UWARG/ZP-breakout/README.md

# ZP-breakout
Breakout Board for Zeropilot rev 1.0.
