UWARG/ZP-breakout/sch.pdf

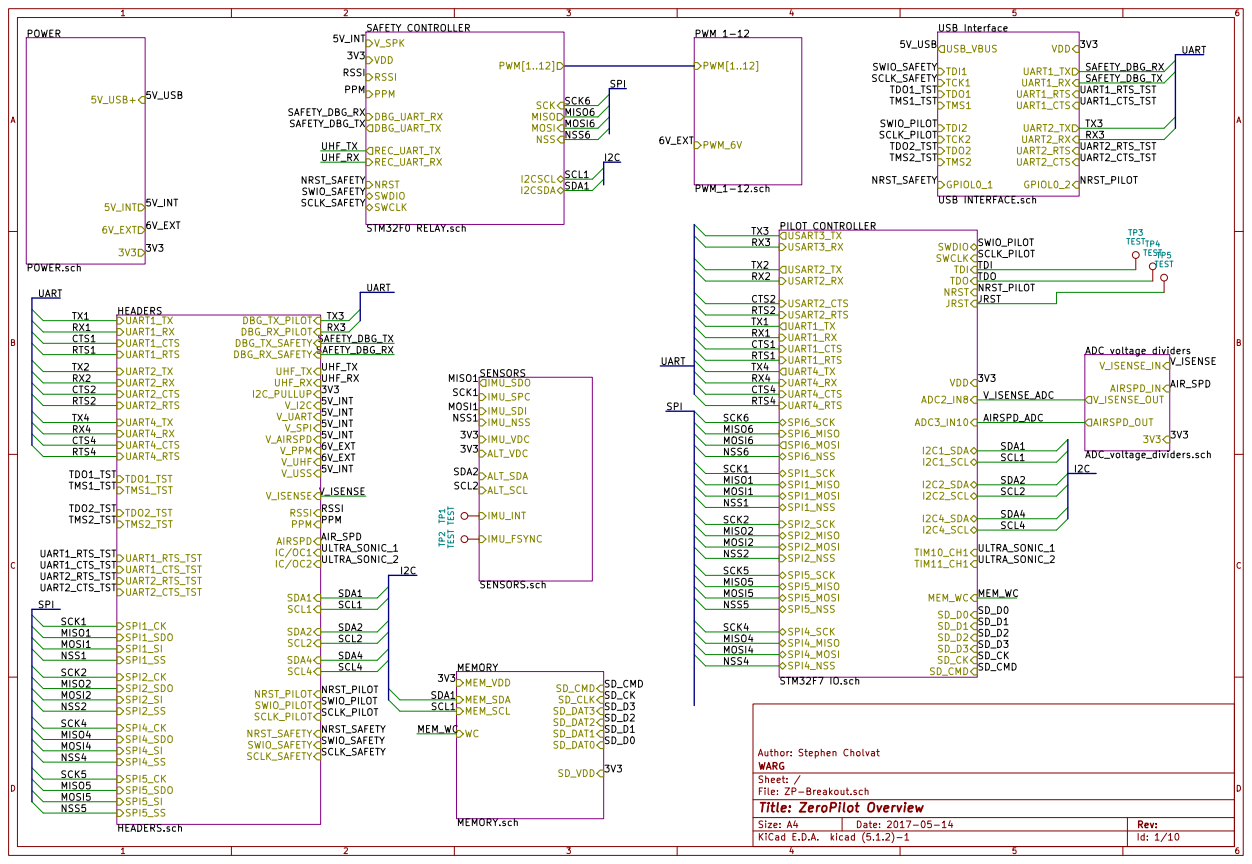
[picture p1: page 1]

Author: Stephen Cholvat
File: ZP-Breakout.sch Sheet: / WARG

Id: 1/10 Title: ZeroPilot Overview

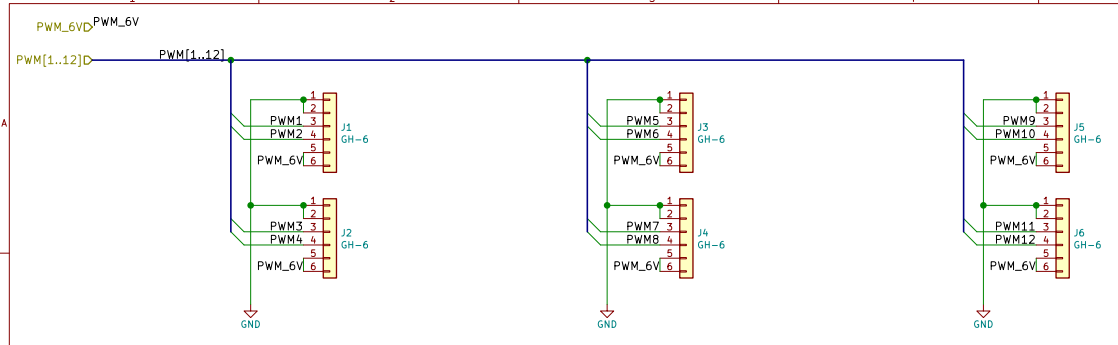
[picture p2: page 2]

Author: Stephen Cholvat
File: PWM_1-12.sch Sheet: /PWM 1-12/ WARG

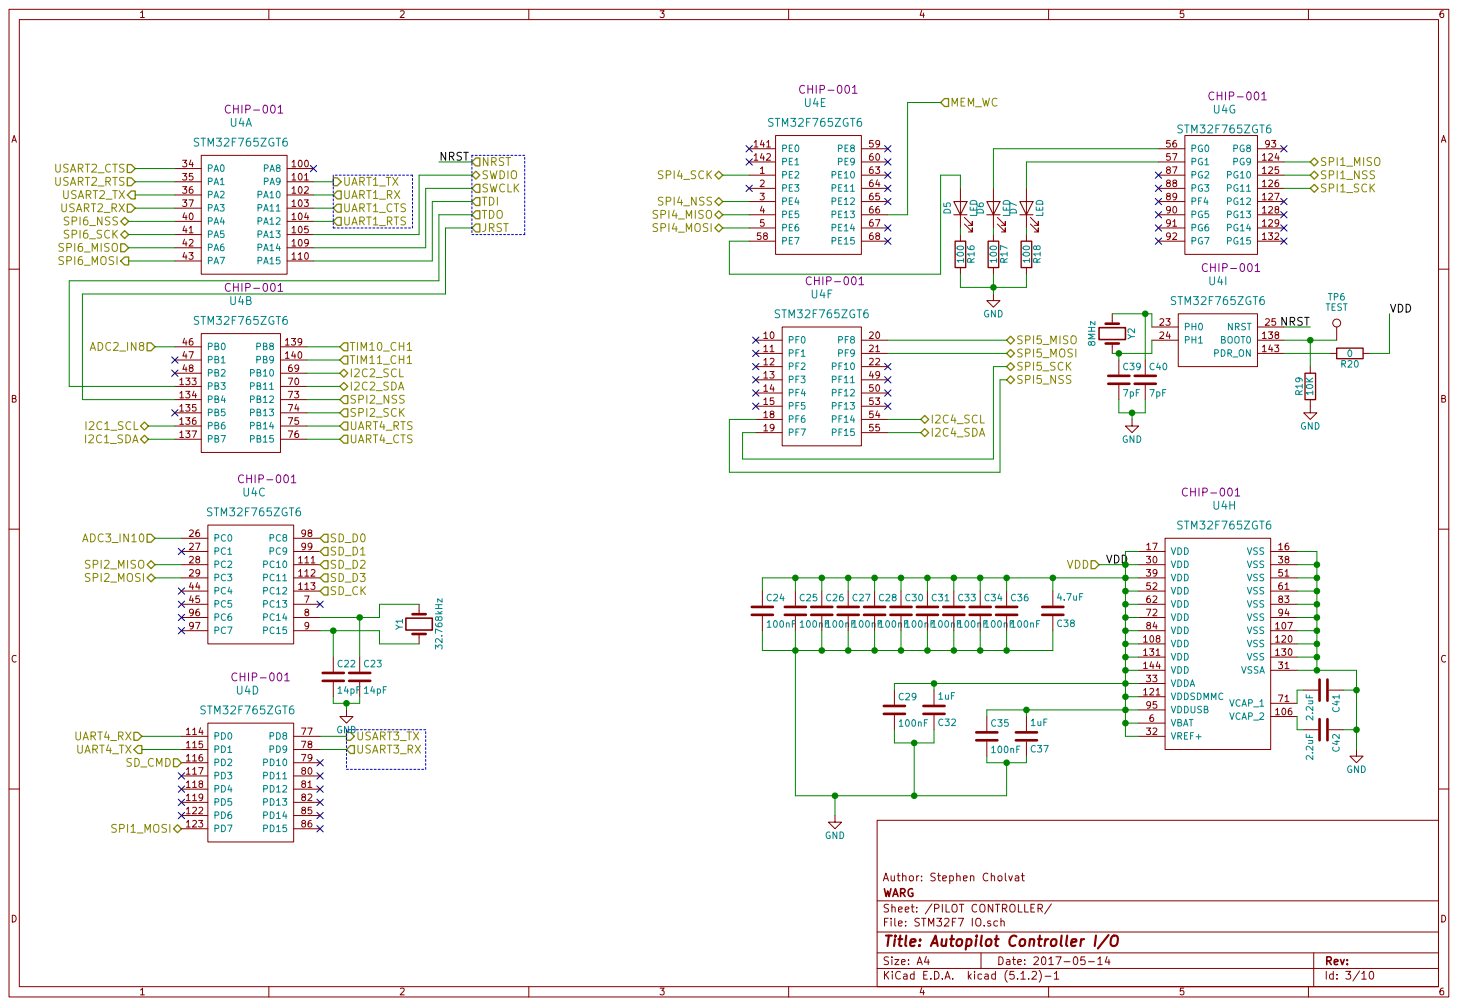
[picture p3: page 3]

Author: Stephen Cholvat
File: STM32F7 IO.sch Sheet: /PILOT CONTROLLER/ WARG

Id: 3/10 Title: Autopilot Controller I/O

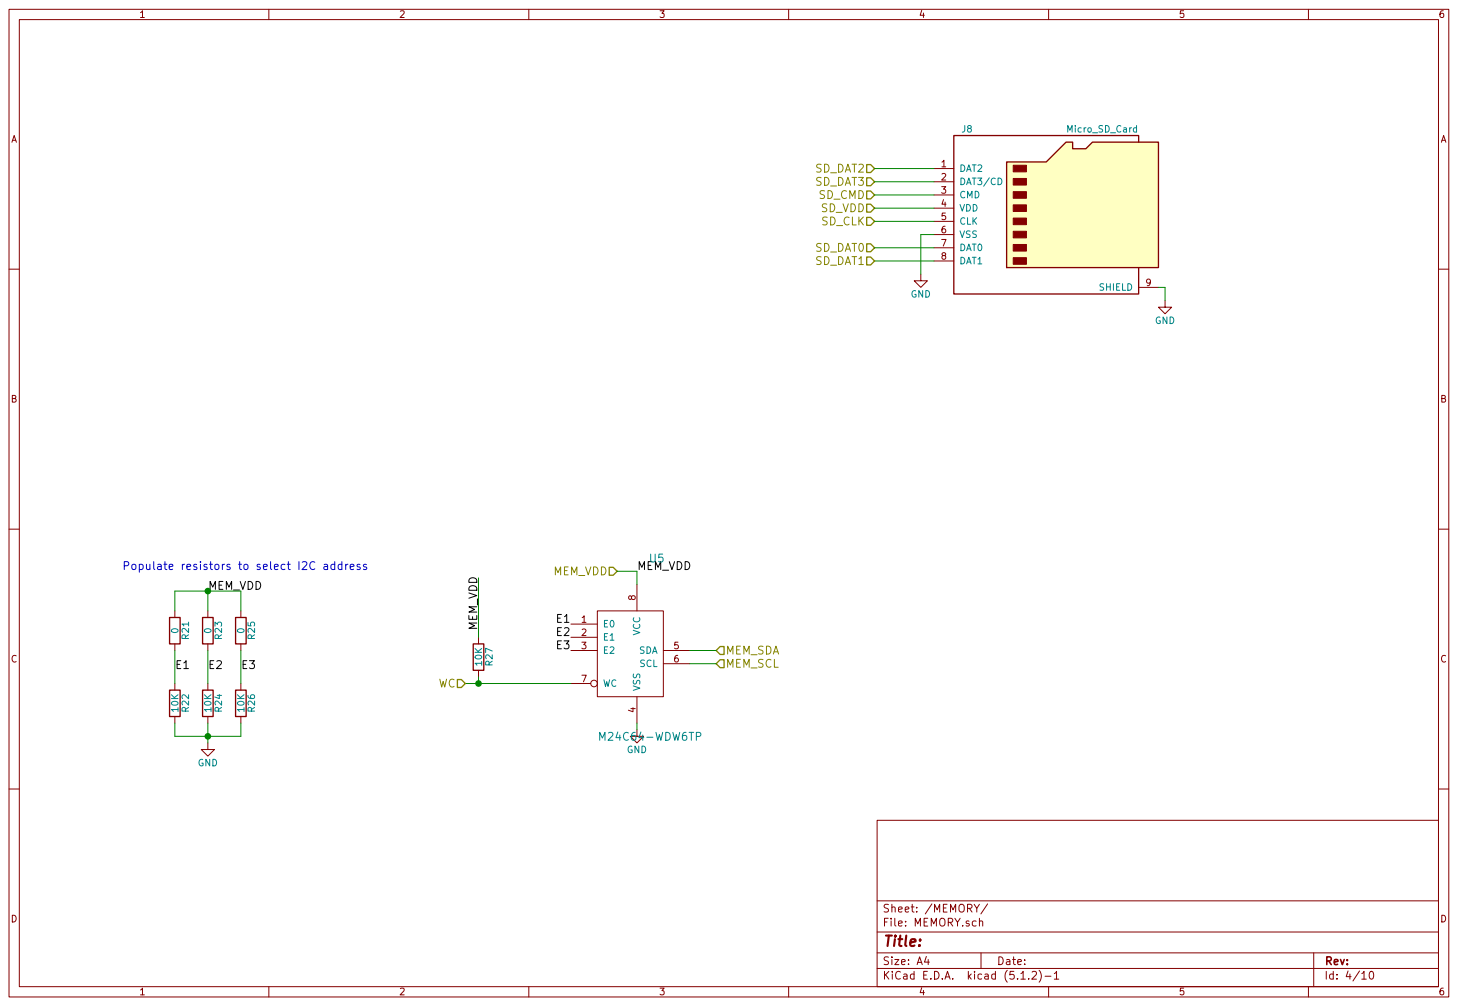
[picture p4: page 4]

4 SDA 5 SCL 6 WC 7 VCC

Id: 4/10 Title: File: MEMORY.sch Sheet: /MEMORY/

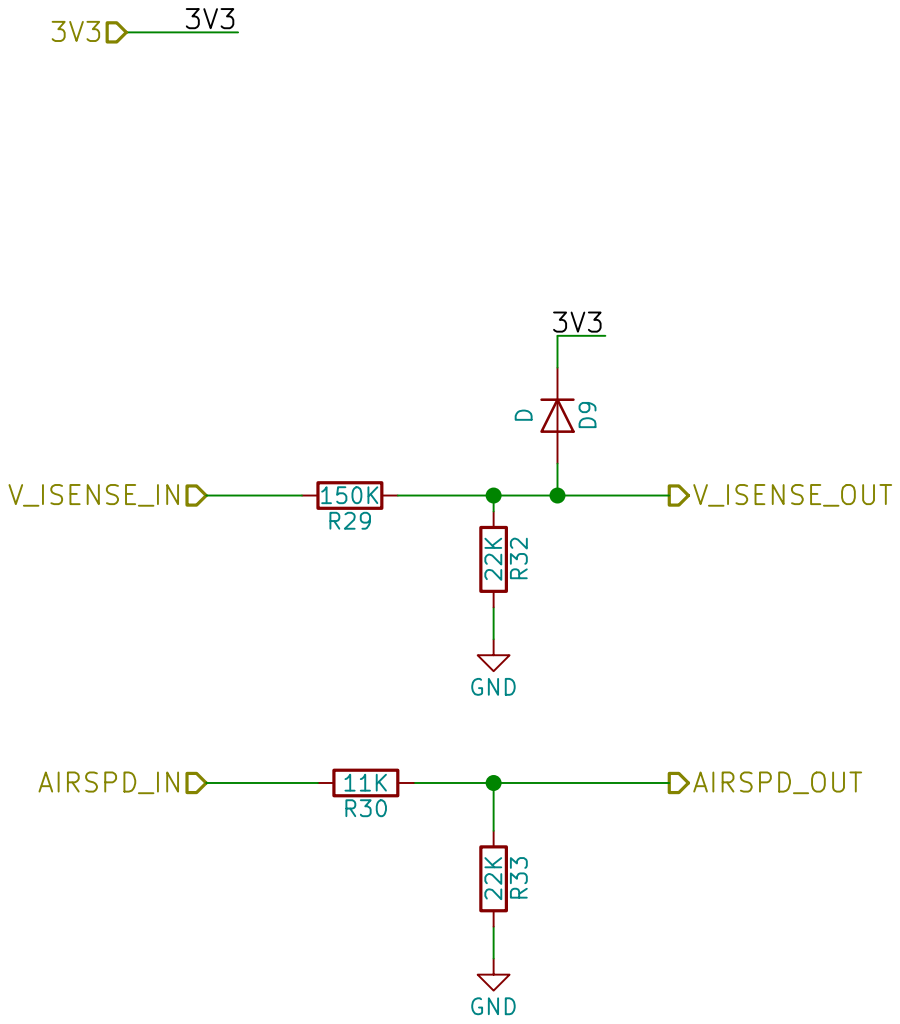
[picture p5: page 5]

Sheet: /ADC voltage dividers/
File: ADC_voltage_dividers.sch
Id: 5/10 Title:

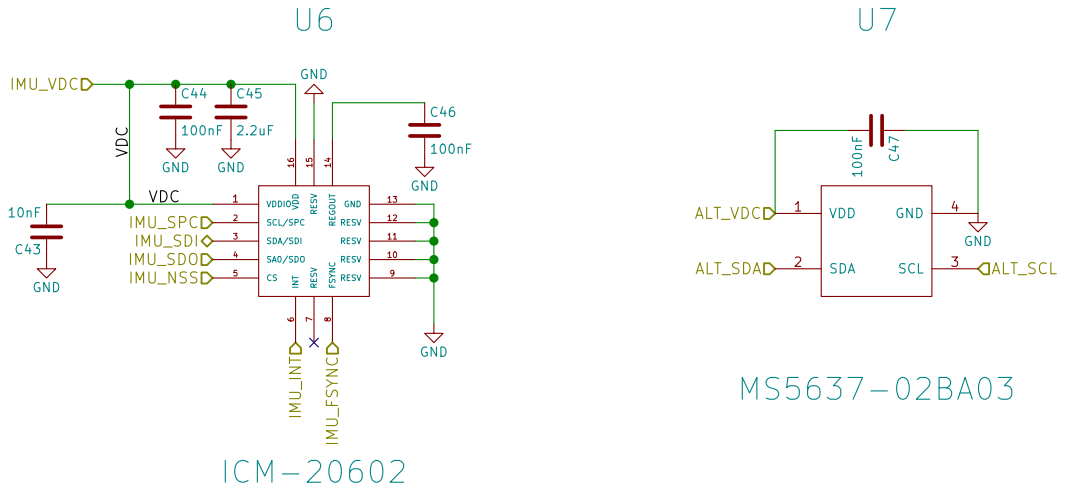
[picture p6: page 6]

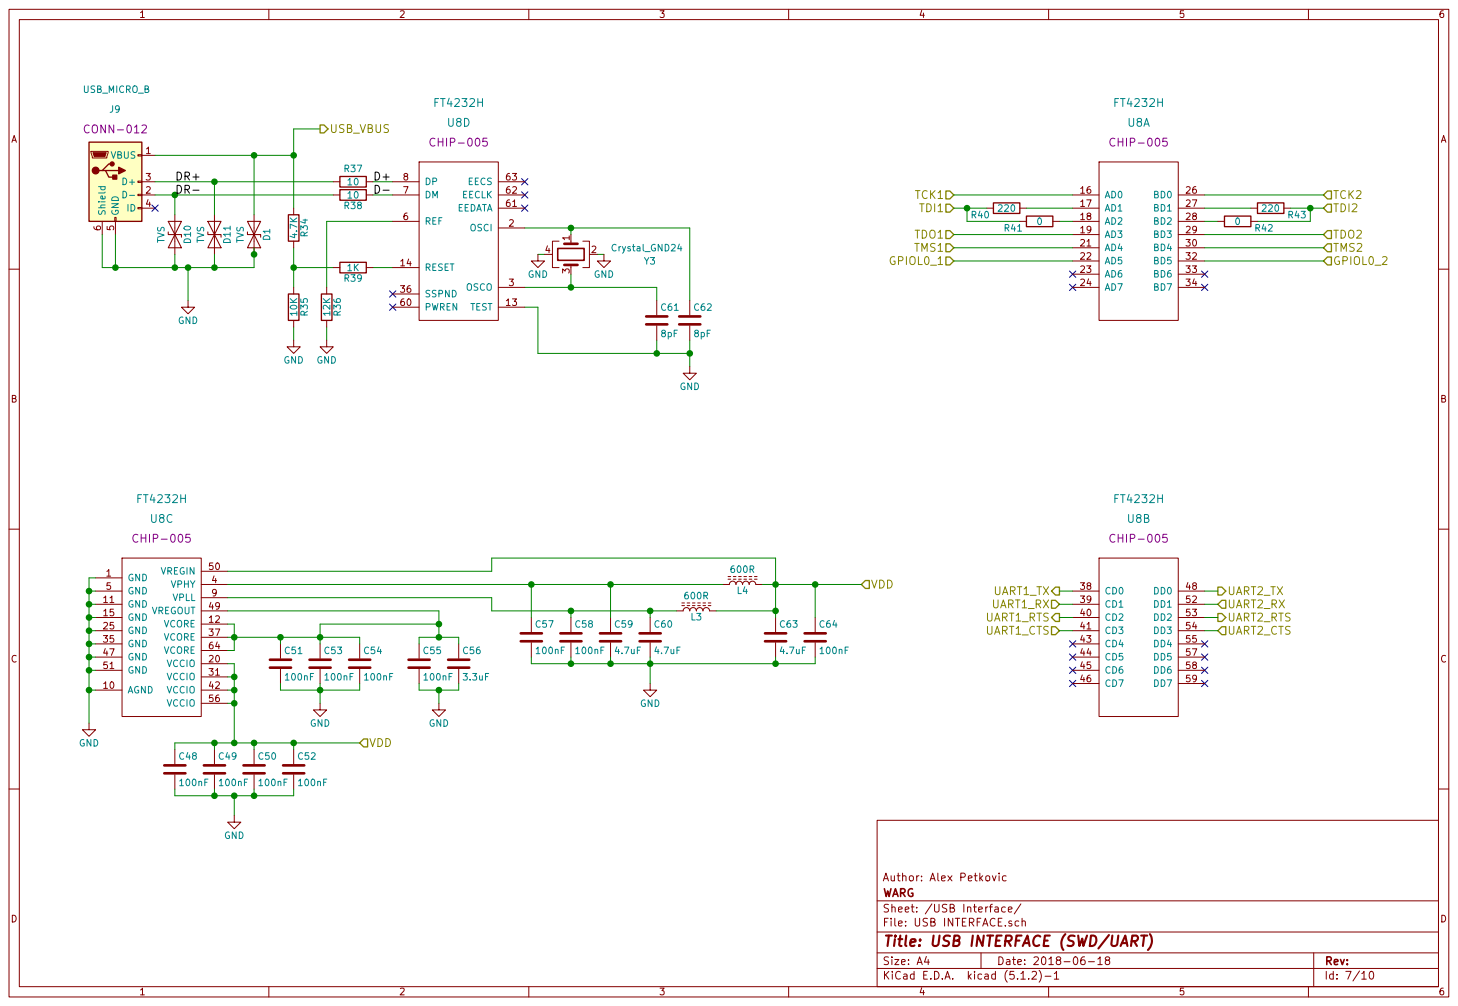
[picture p7: page 7]

Id: 7/10 Title: USB INTERFACE (SWD/UART) File: USB INTERFACE.sch Sheet: /USB Interface/ WARG

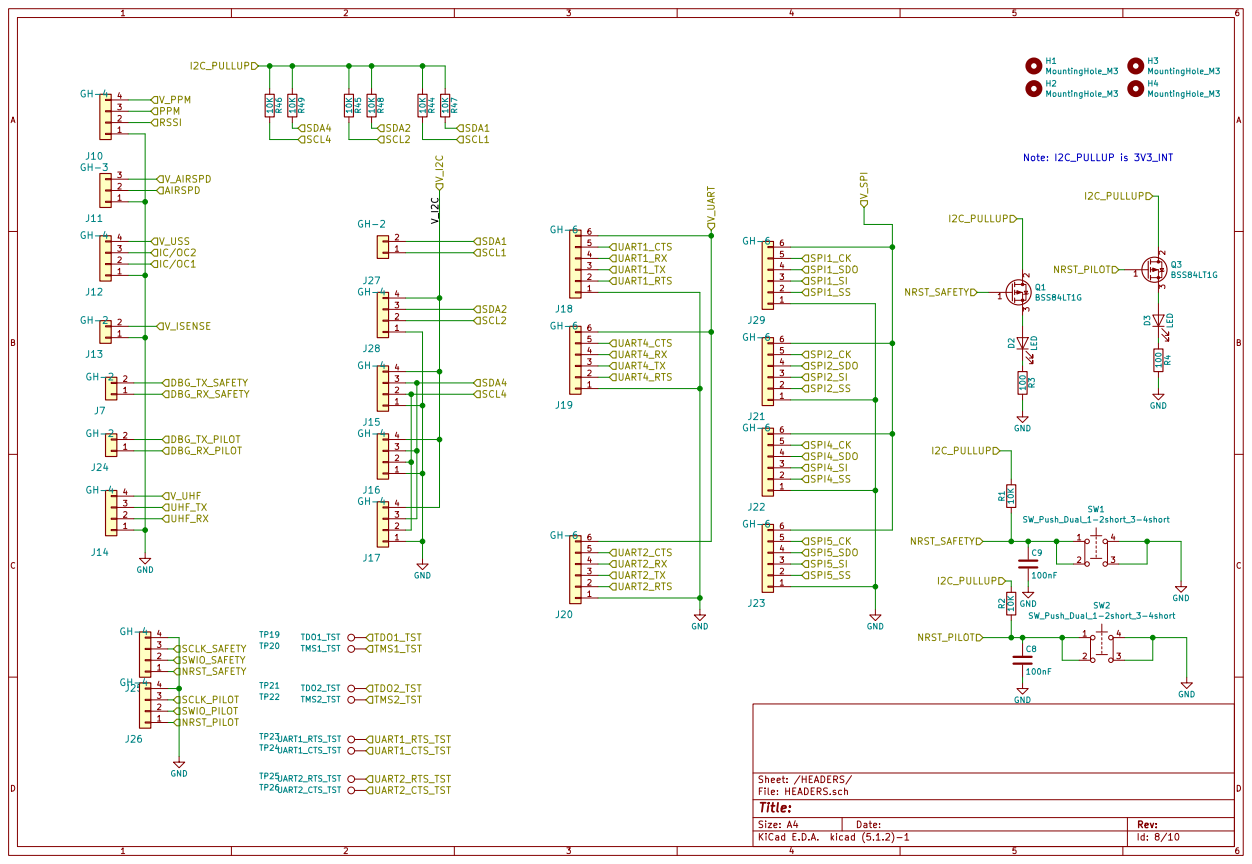
[picture p8: page 8]

Id: 8/10 Title: File: HEADERS.sch Sheet: /HEADERS/

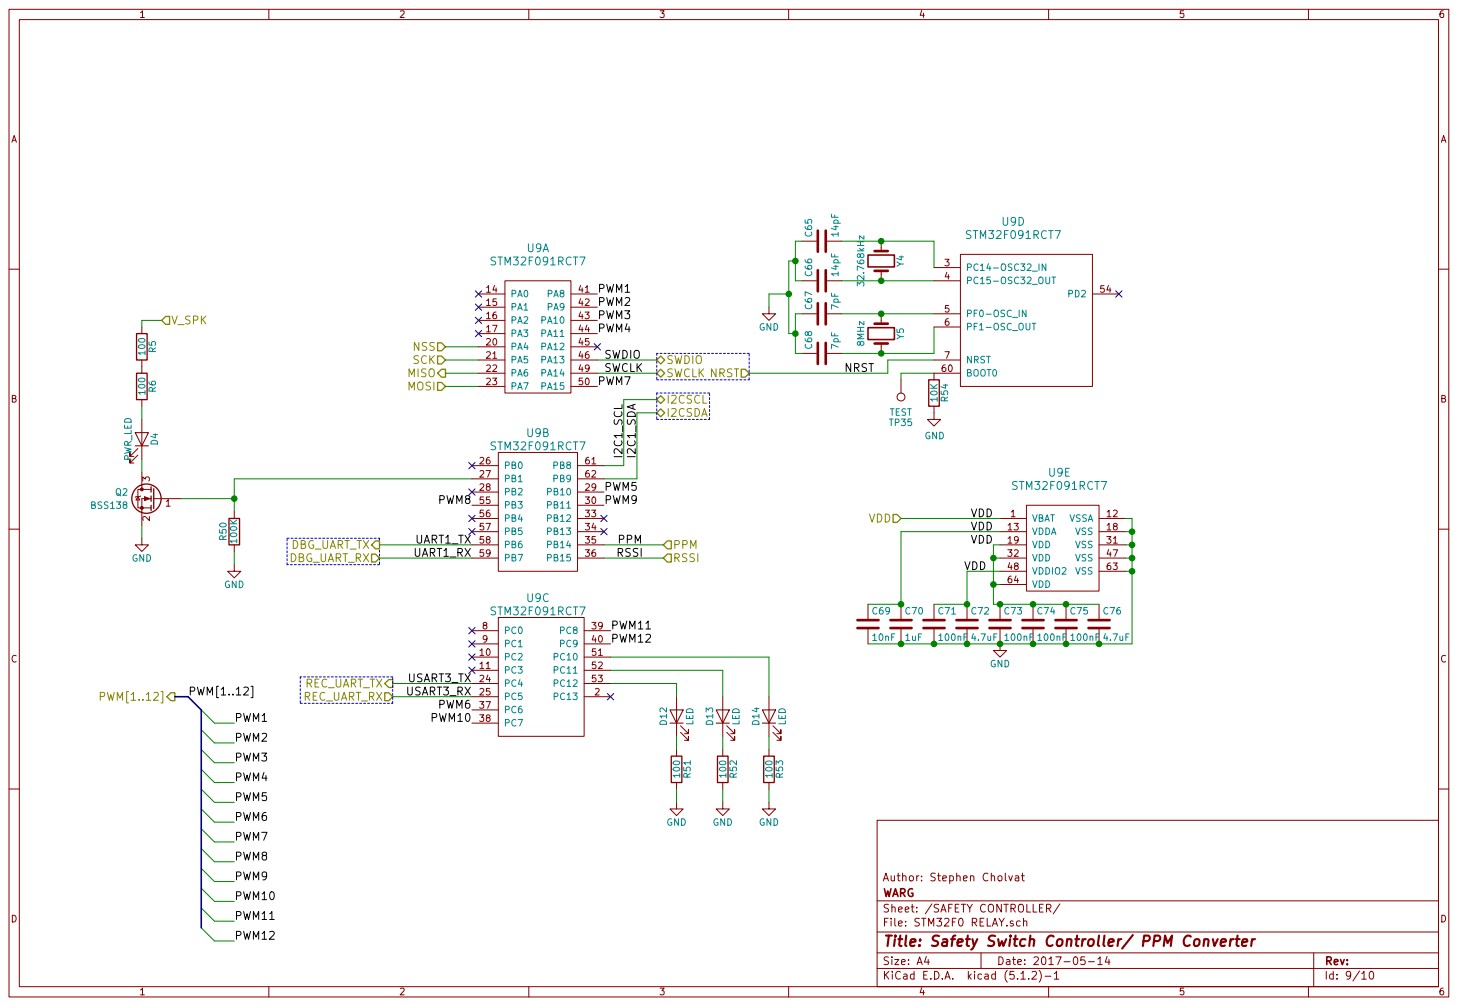
[picture p9: page 9]

Id: 9/10 Title: Safety Switch Controller/ PPM Converter File: STM32F0 RELAY.sch Sheet: /SAFETY CONTROLLER/ WARG

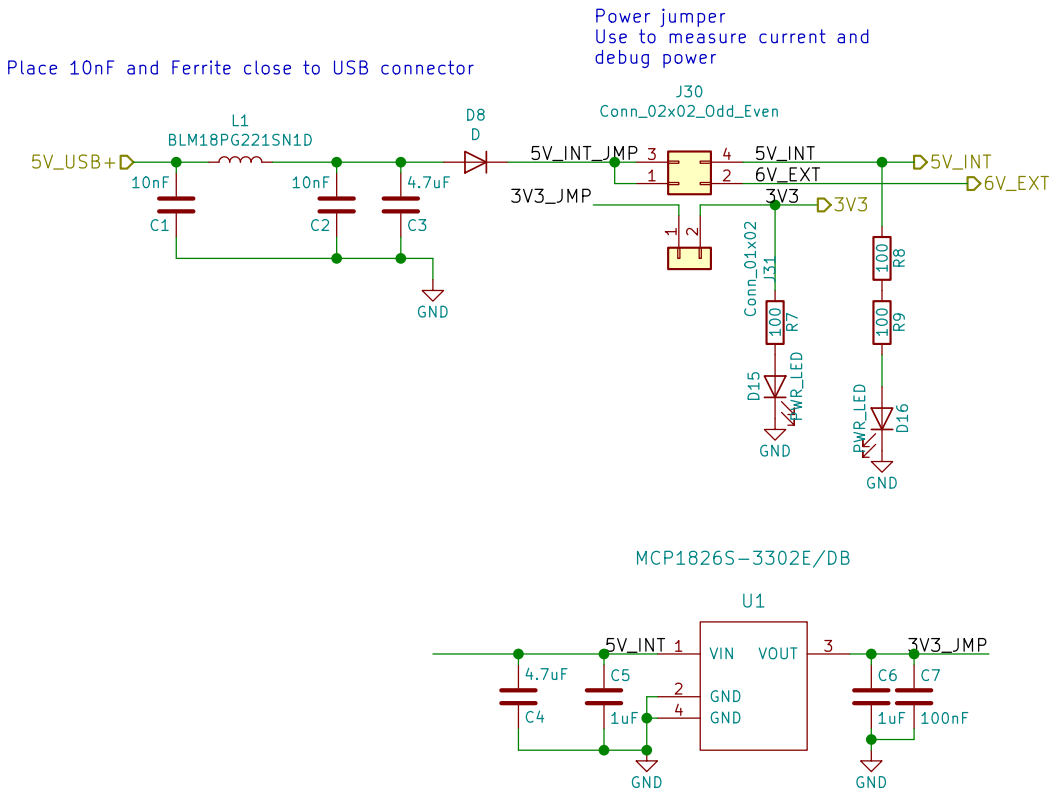
[picture p10: page 10]

Power jumper Use to measure current and
debug power C5
6V_EXT

Id: 10/10 Title: File: POWER.sch Sheet: /POWER/ WARG
