UWARG/ZP-breakout/pcb.pdf

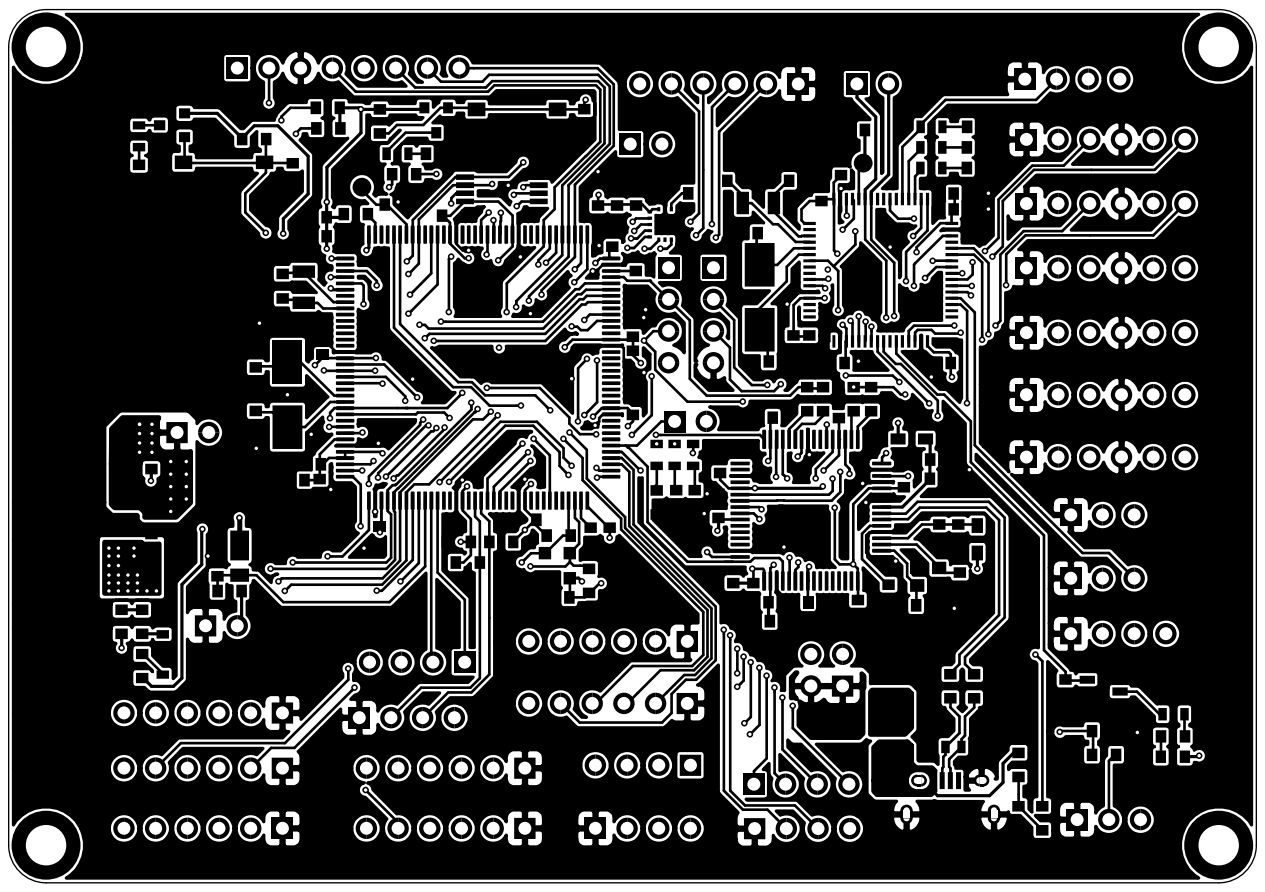
[picture p11: page 1]

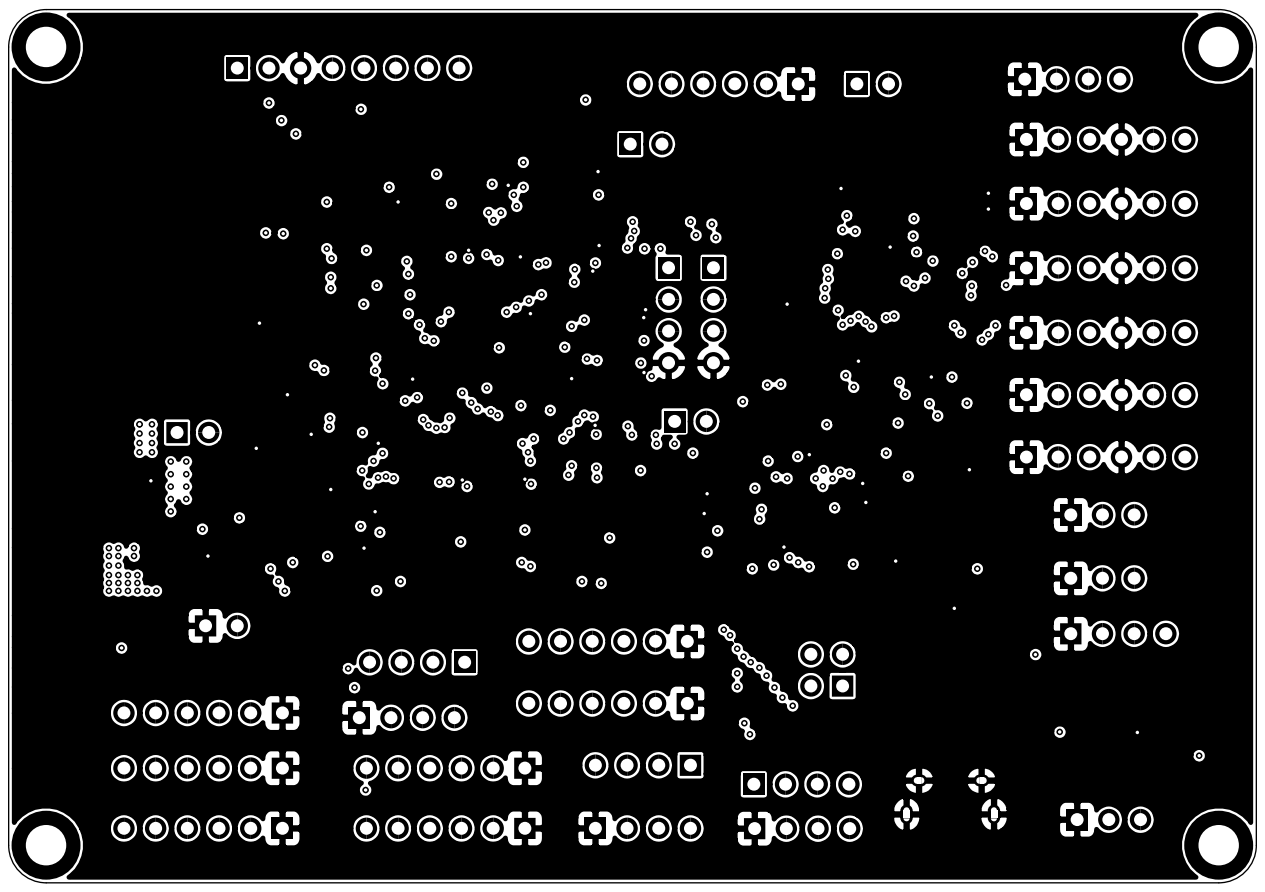
[picture p12: page 2]

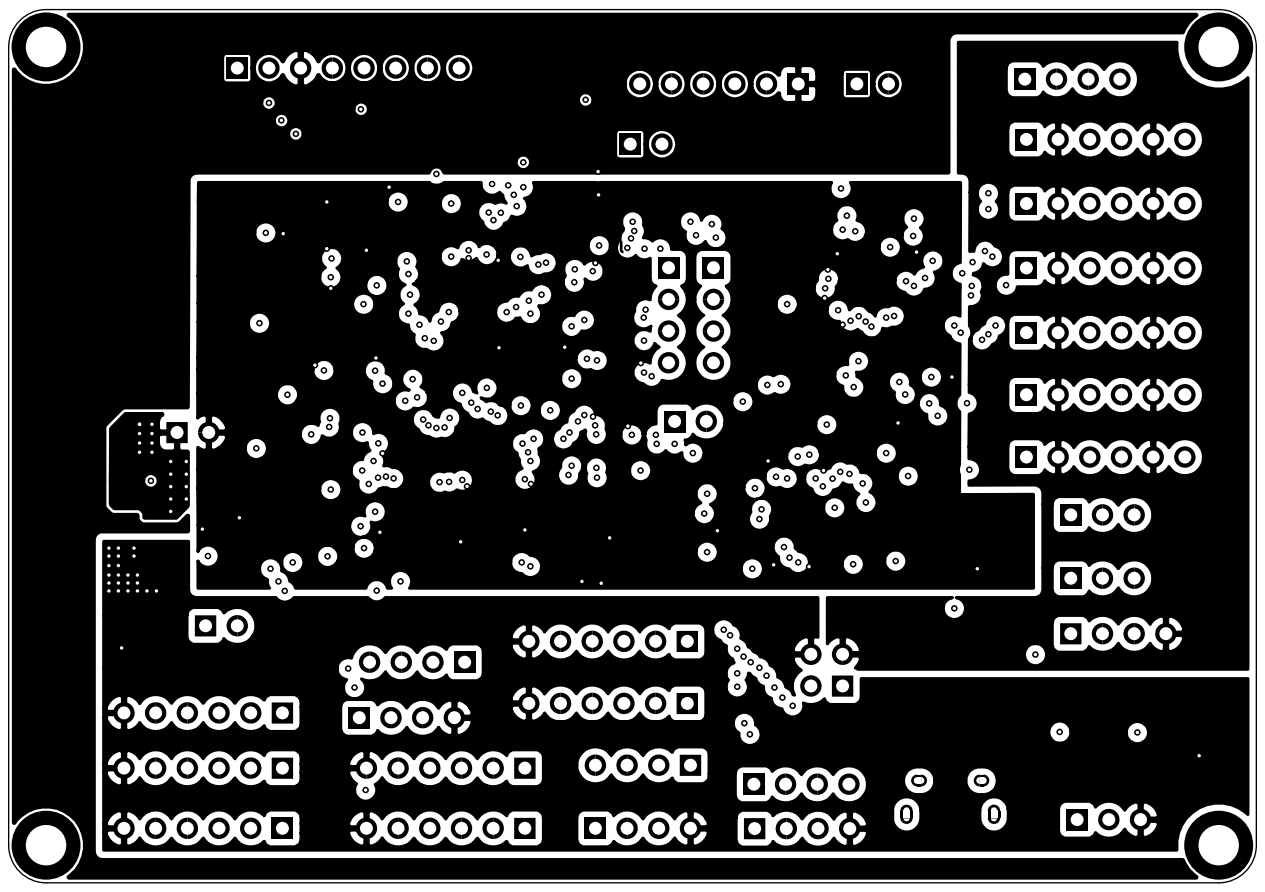
[picture p13: page 3]

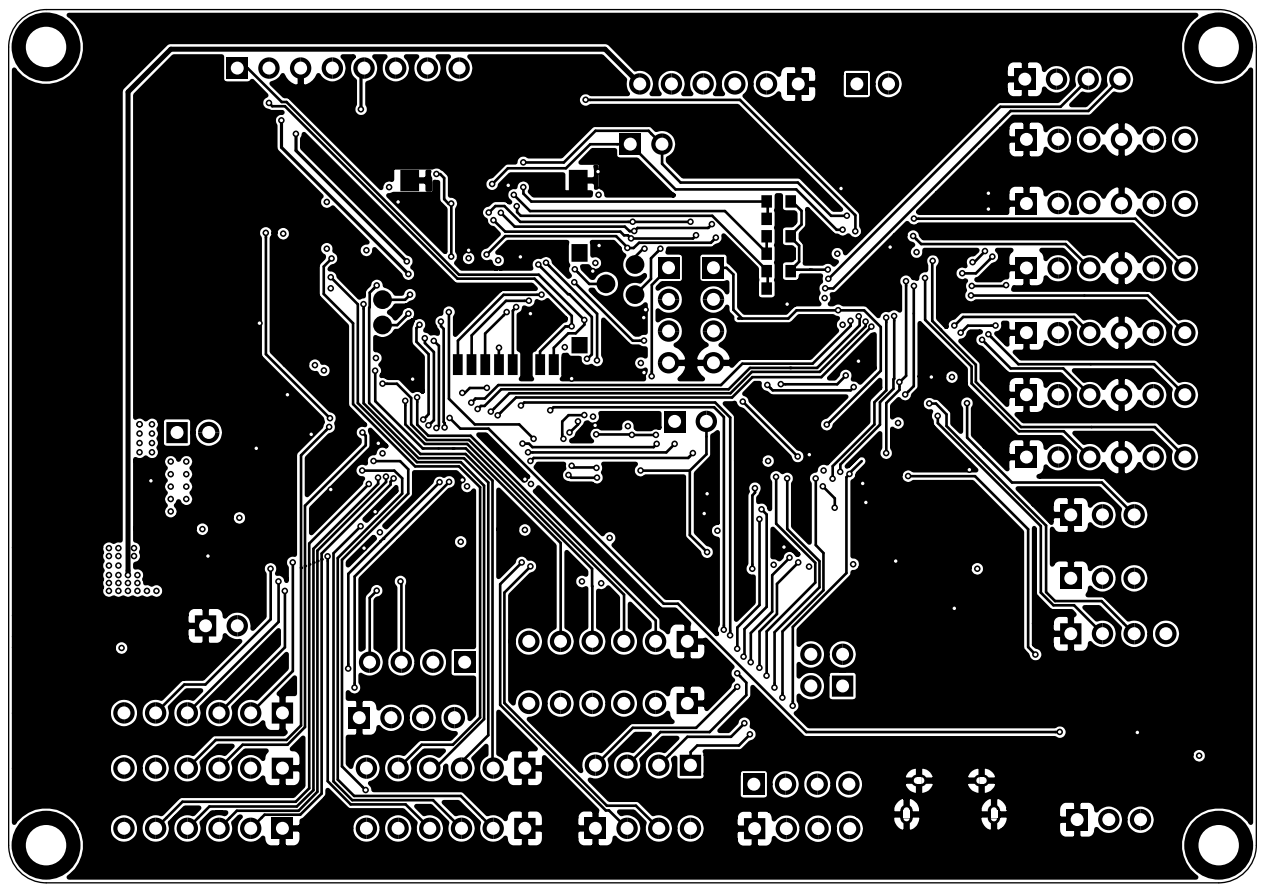
[picture p14: page 4]

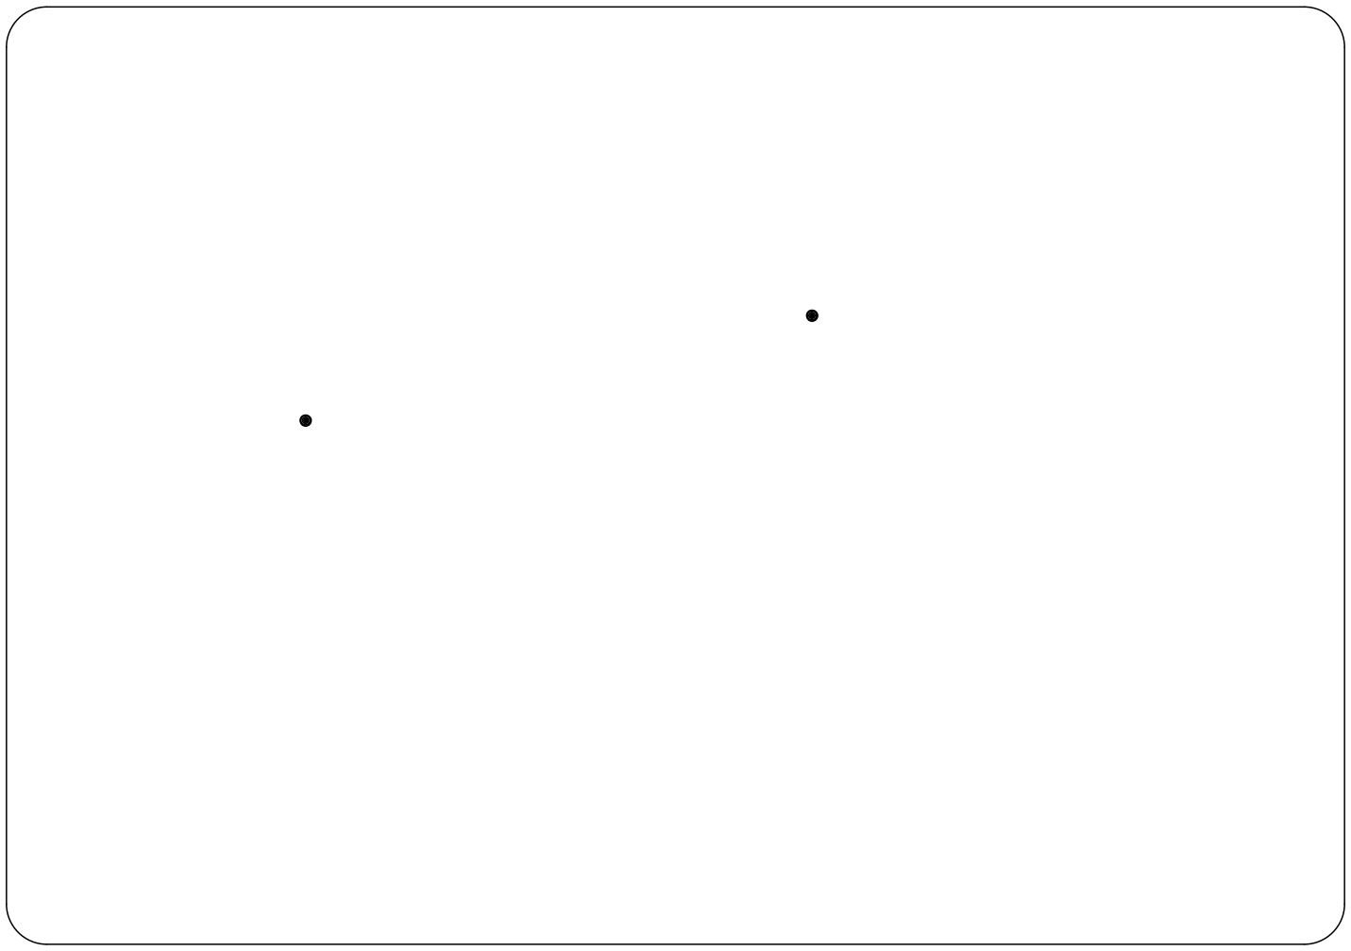
[picture p15: figure]

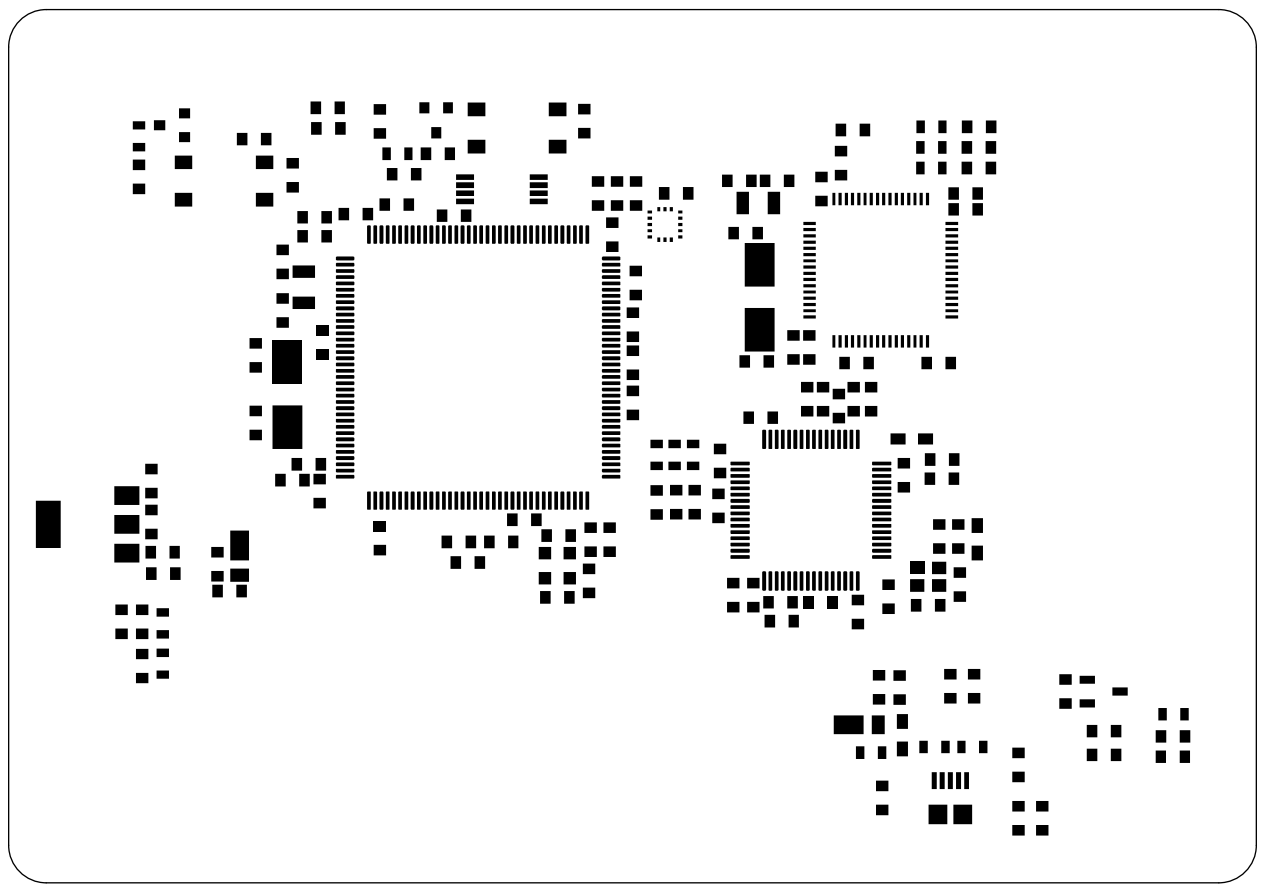
[picture p16: page 7]

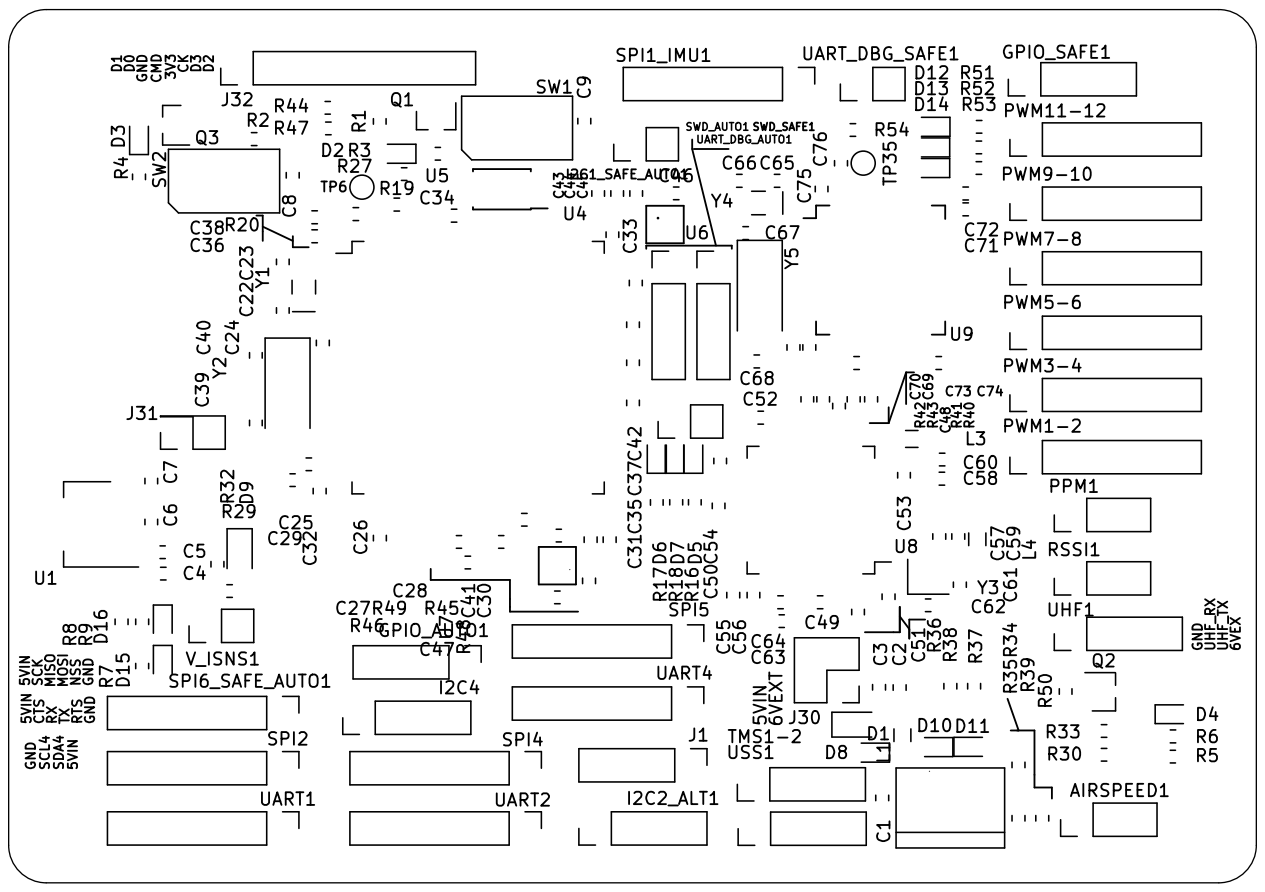
[picture p17: page 9]

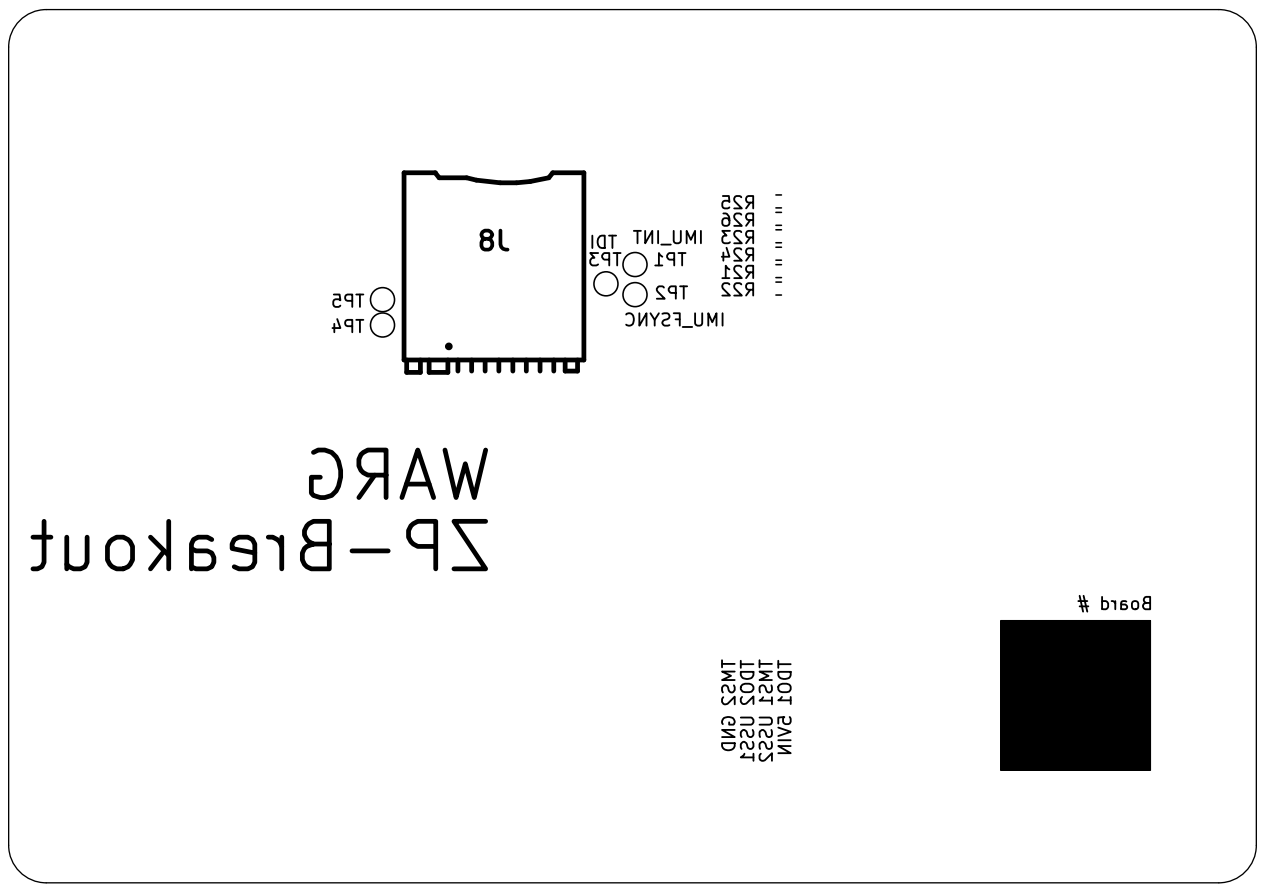
[picture p18: page 10]

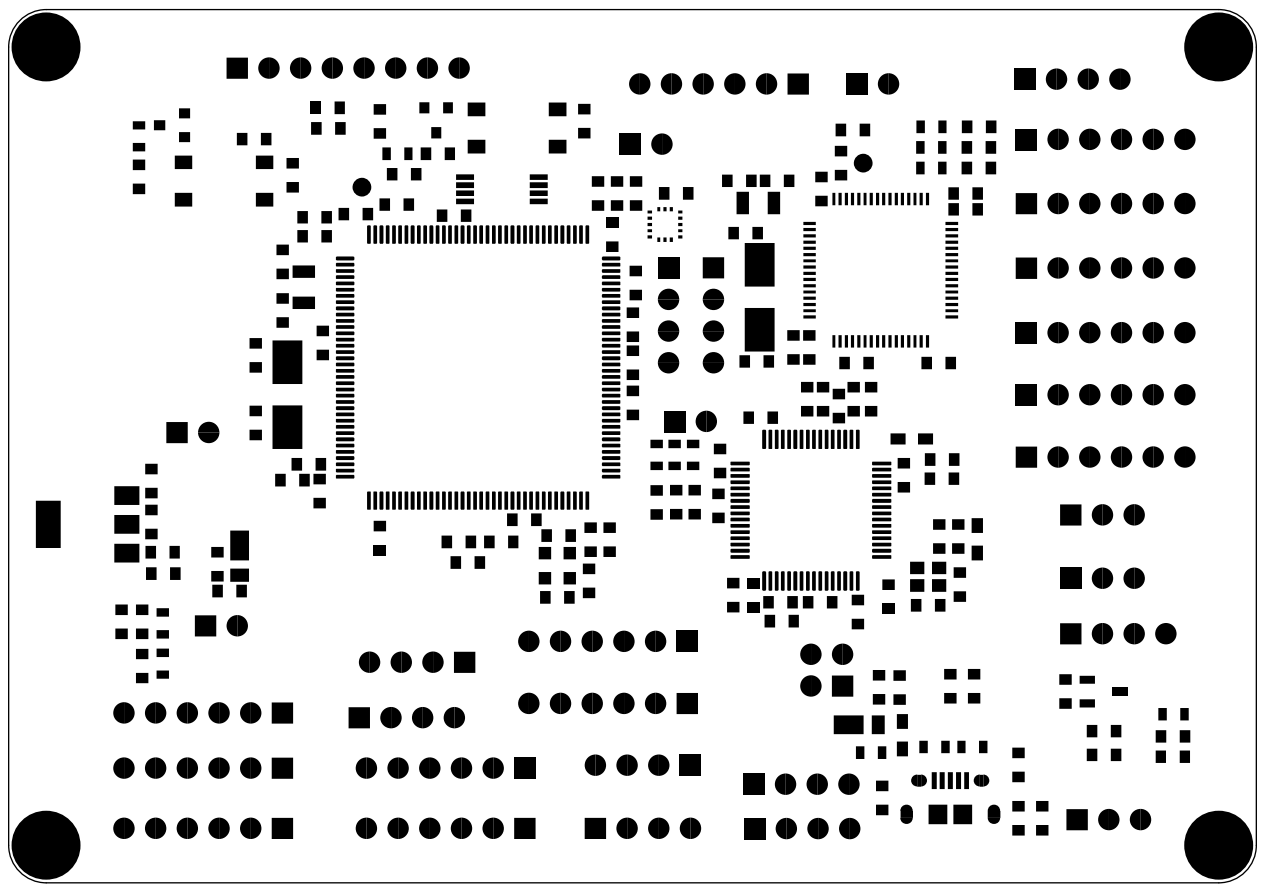
[picture p19: page 11]

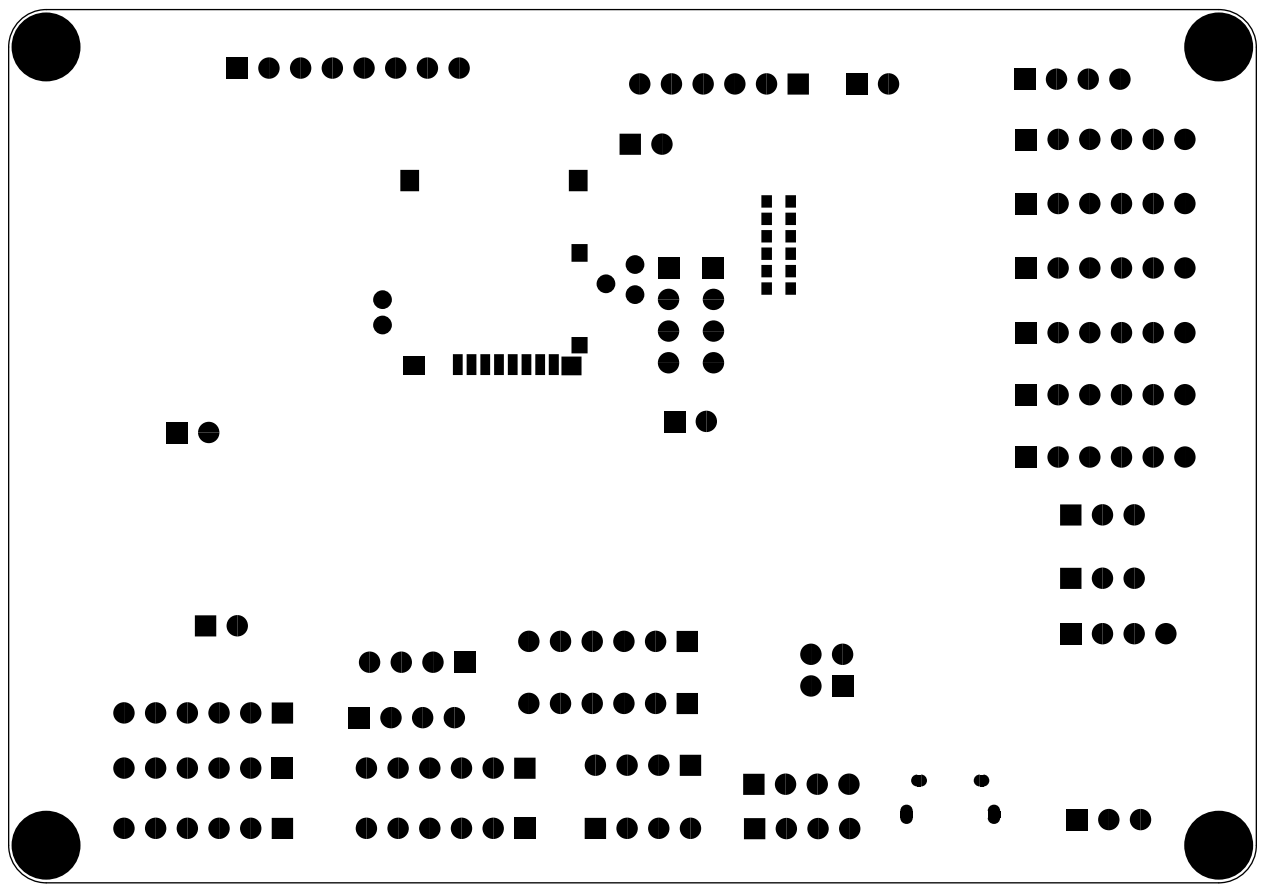
[picture p20: page 12]

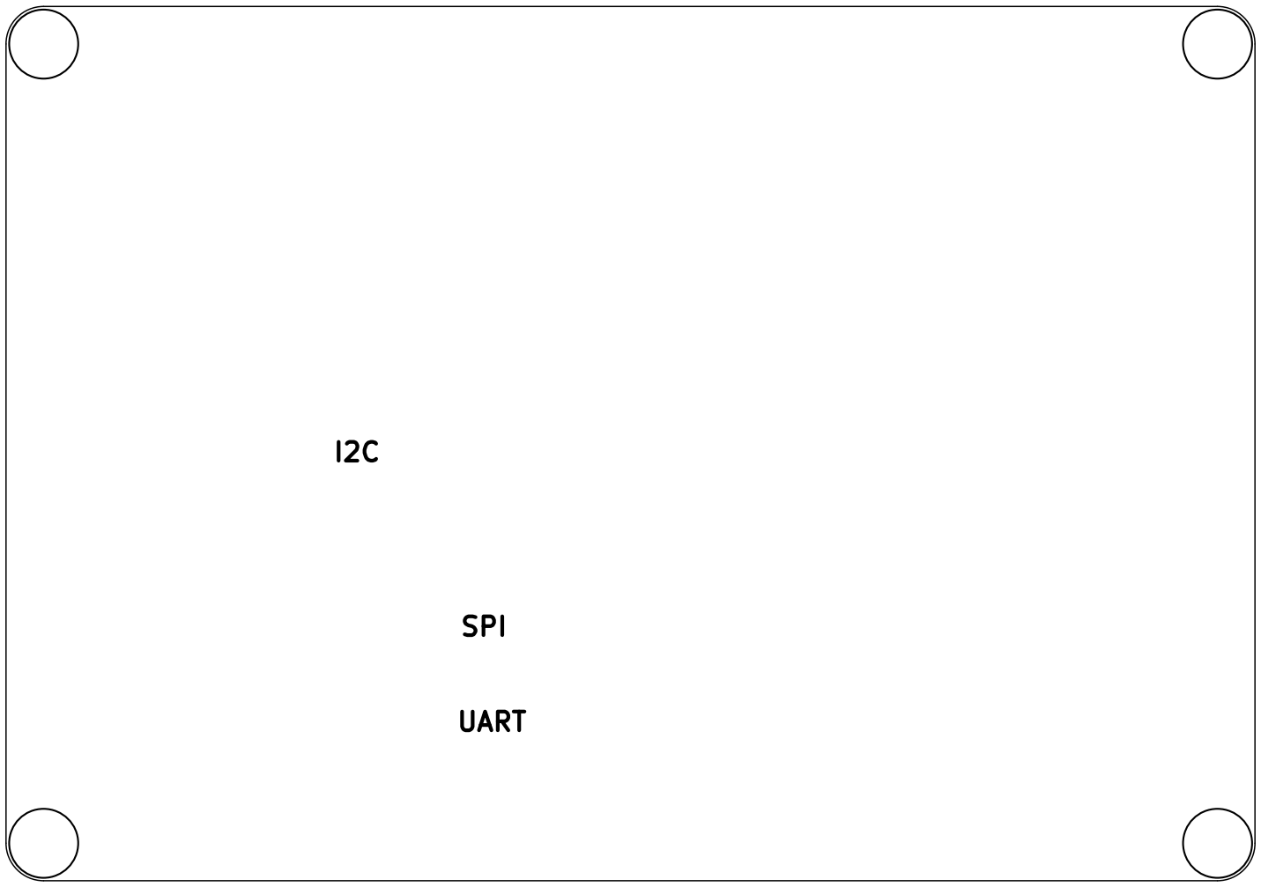
[picture p21: figure]

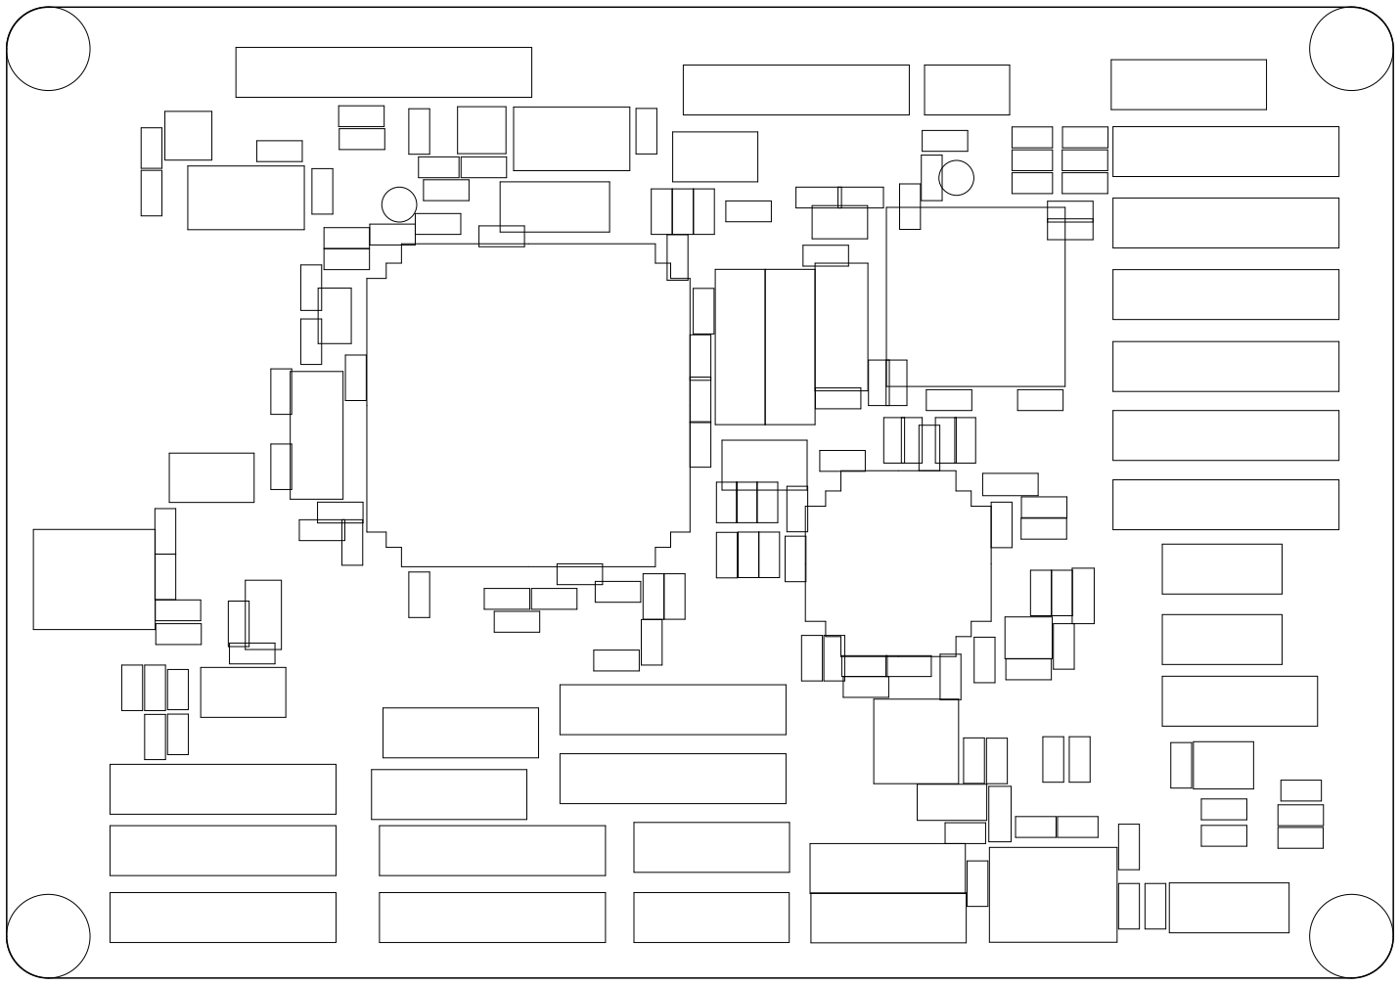
[picture p22: figure]

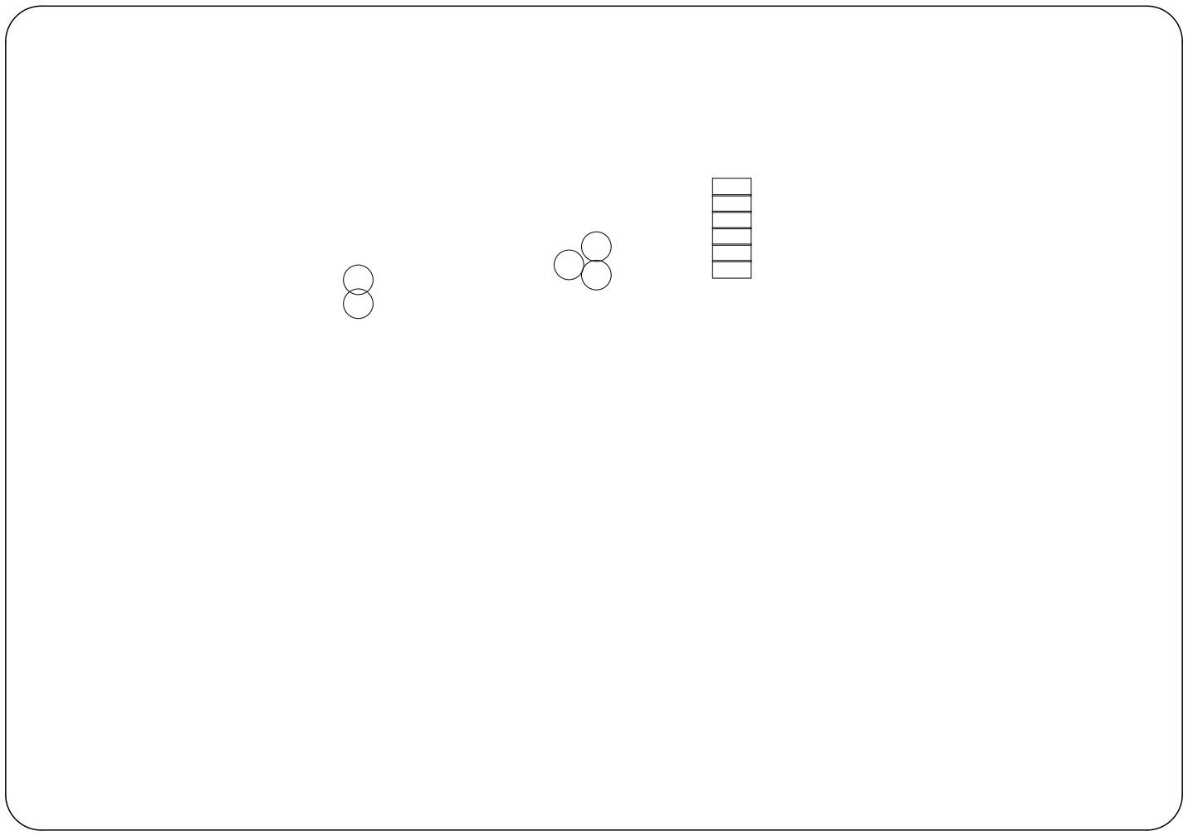
[picture p23: figure]
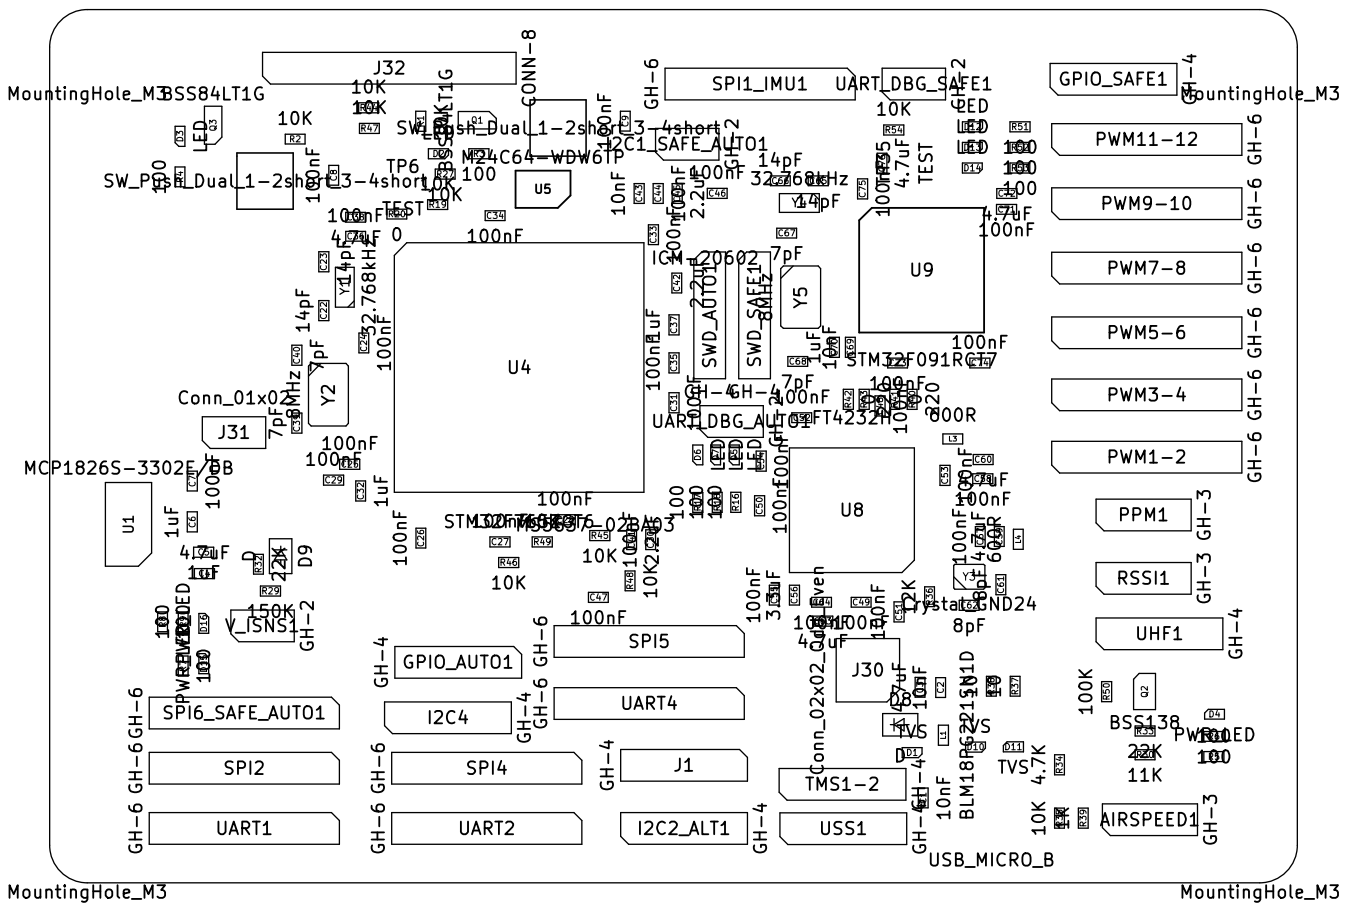
[picture p24: page 21]

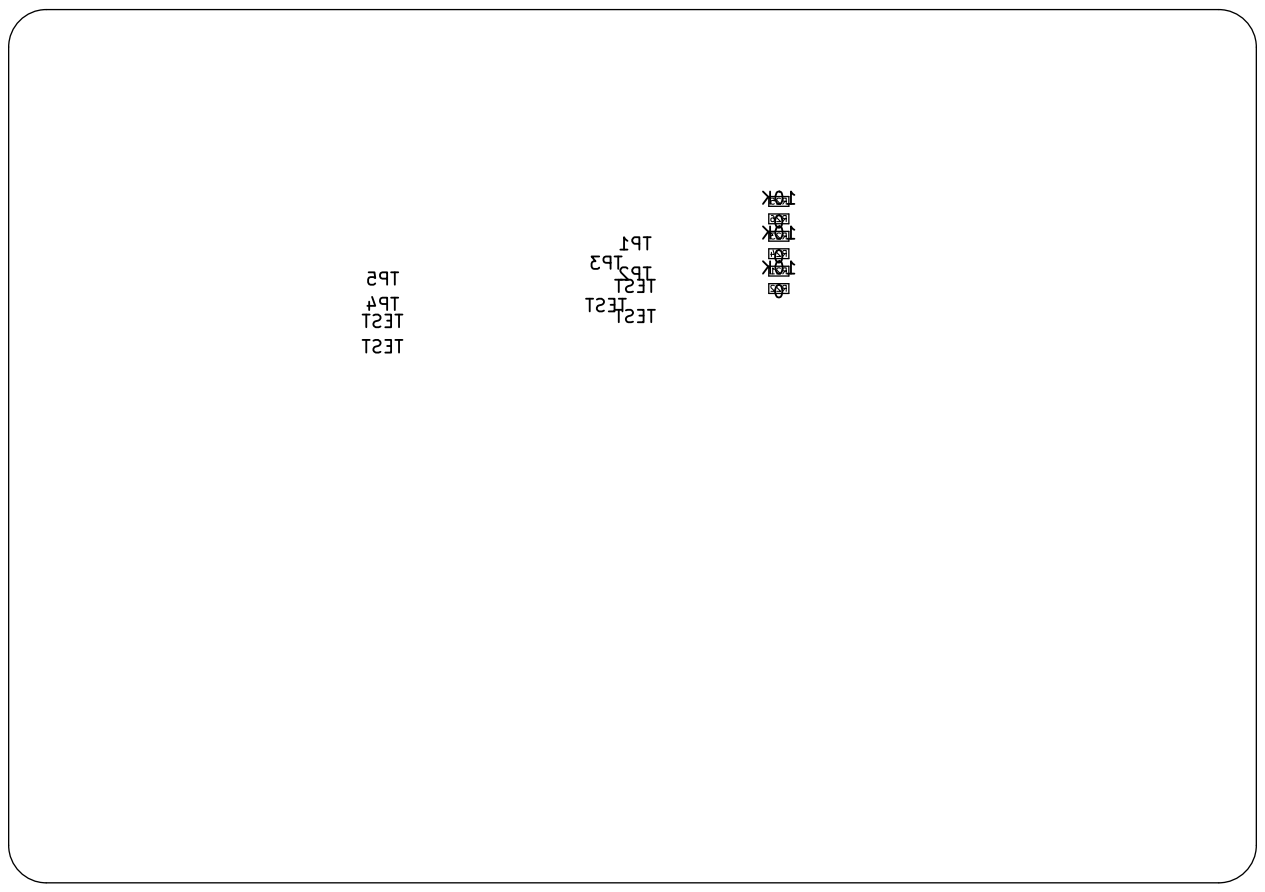
[picture p25: page 22]
