UWARG/ZP-breakout/Hardware/ZP-Breakout.kicad_pcb

## KiCad design Hardware/ZP-Breakout.kicad_pcb (2021-02-02)

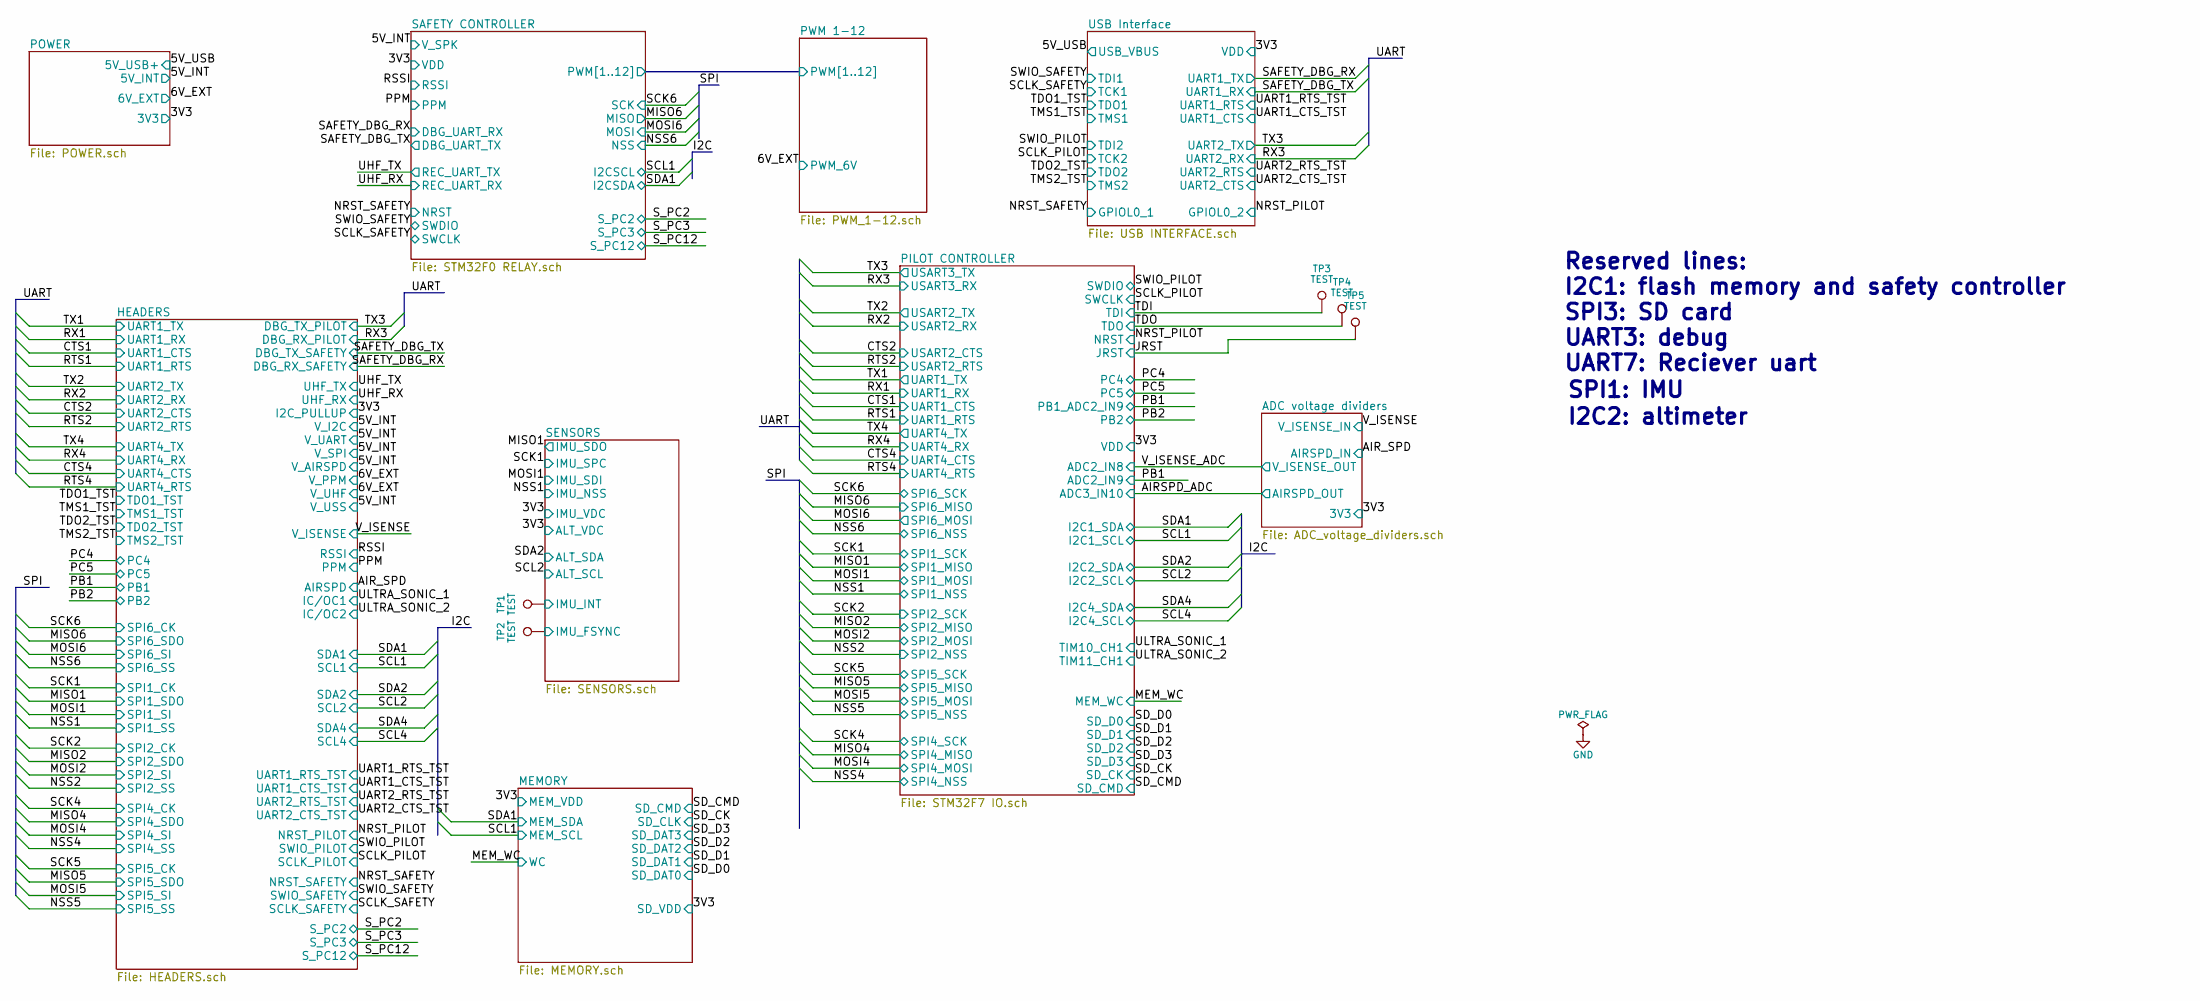
[picture p26: schematic ZP-Breakout.sch, ZeroPilot Overview]

Parts:
TP1, TP2, TP3, TP4, TP5: TEST; TestPoint_Pad_D1.5mm

Connections:
/JRST: TP5.1; also elsewhere on the board
/SENSORS/IMU_FSYNC: TP2.1; also elsewhere on the board
/SENSORS/IMU_INT: TP1.1; also elsewhere on the board
/TDI: TP3.1; also elsewhere on the board
/TDO: TP4.1; also elsewhere on the board

Notes on the sheet:
Reserved lines: I2C1: flash memory and safety controller SPI3: SD card UART3: debug UART7: Reciever uart
SPI1: IMU
I2C2: altimeter

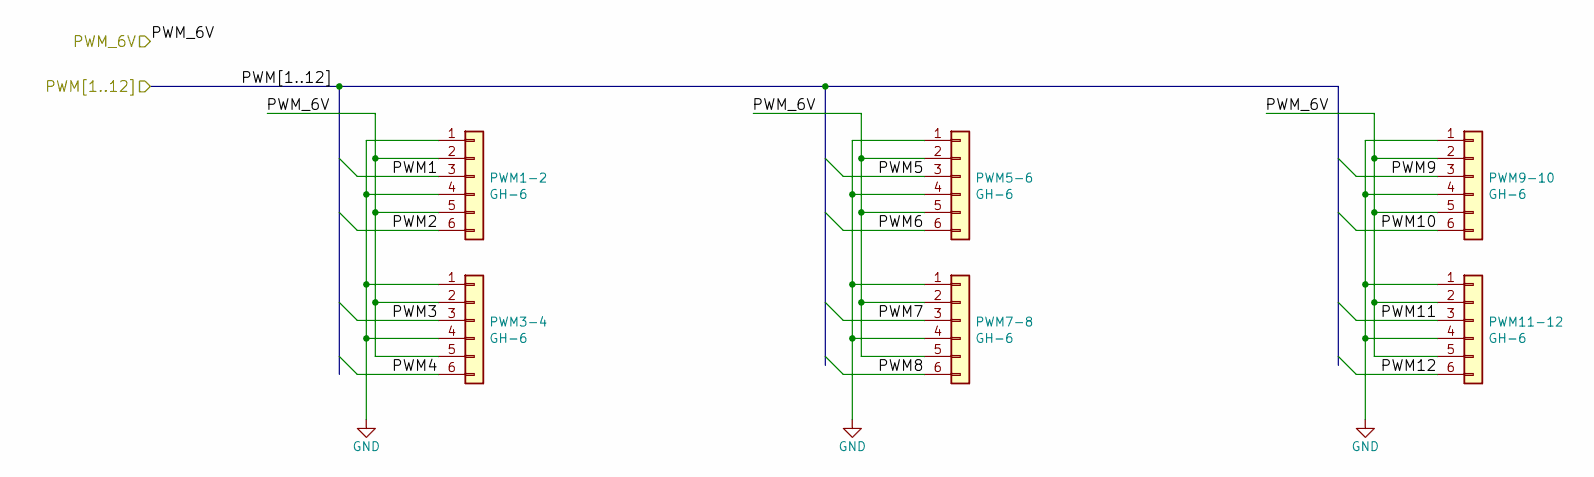
[picture p27: schematic PWM_1-12.sch, PWM 1-12]

Parts:
PWM1-2, PWM3-4, PWM5-6, PWM7-8, PWM9-10, PWM11-12: GH-6; PinHeader_1x06_P2.54mm_Vertical; part_num CONN-009

Connections:
/6V_EXT: PWM1-2.2, PWM1-2.5, PWM3-4.2, PWM3-4.5, PWM5-6.2, PWM5-6.5, PWM7-8.2, PWM7-8.5, PWM9-10.2, PWM9-10.5, PWM11-12.2, PWM11-12.5; also elsewhere on the board
/PWM 1-12/PWM1: PWM1-2.3; also elsewhere on the board
/PWM 1-12/PWM2: PWM1-2.6; also elsewhere on the board
/PWM 1-12/PWM3: PWM3-4.3; also elsewhere on the board
/PWM 1-12/PWM4: PWM3-4.6; also elsewhere on the board
/PWM 1-12/PWM5: PWM5-6.3; also elsewhere on the board
/PWM 1-12/PWM6: PWM5-6.6; also elsewhere on the board
/PWM 1-12/PWM7: PWM7-8.3; also elsewhere on the board
/PWM 1-12/PWM8: PWM7-8.6; also elsewhere on the board
/PWM 1-12/PWM9: PWM9-10.3; also elsewhere on the board
/PWM 1-12/PWM10: PWM9-10.6; also elsewhere on the board
/PWM 1-12/PWM11: PWM11-12.3; also elsewhere on the board
/PWM 1-12/PWM12: PWM11-12.6; also elsewhere on the board
GND: PWM1-2.1, PWM1-2.4, PWM3-4.1, PWM3-4.4, PWM5-6.1, PWM5-6.4, PWM7-8.1, PWM7-8.4, PWM9-10.1, PWM9-10.4, PWM11-12.1, PWM11-12.4; also elsewhere on the board

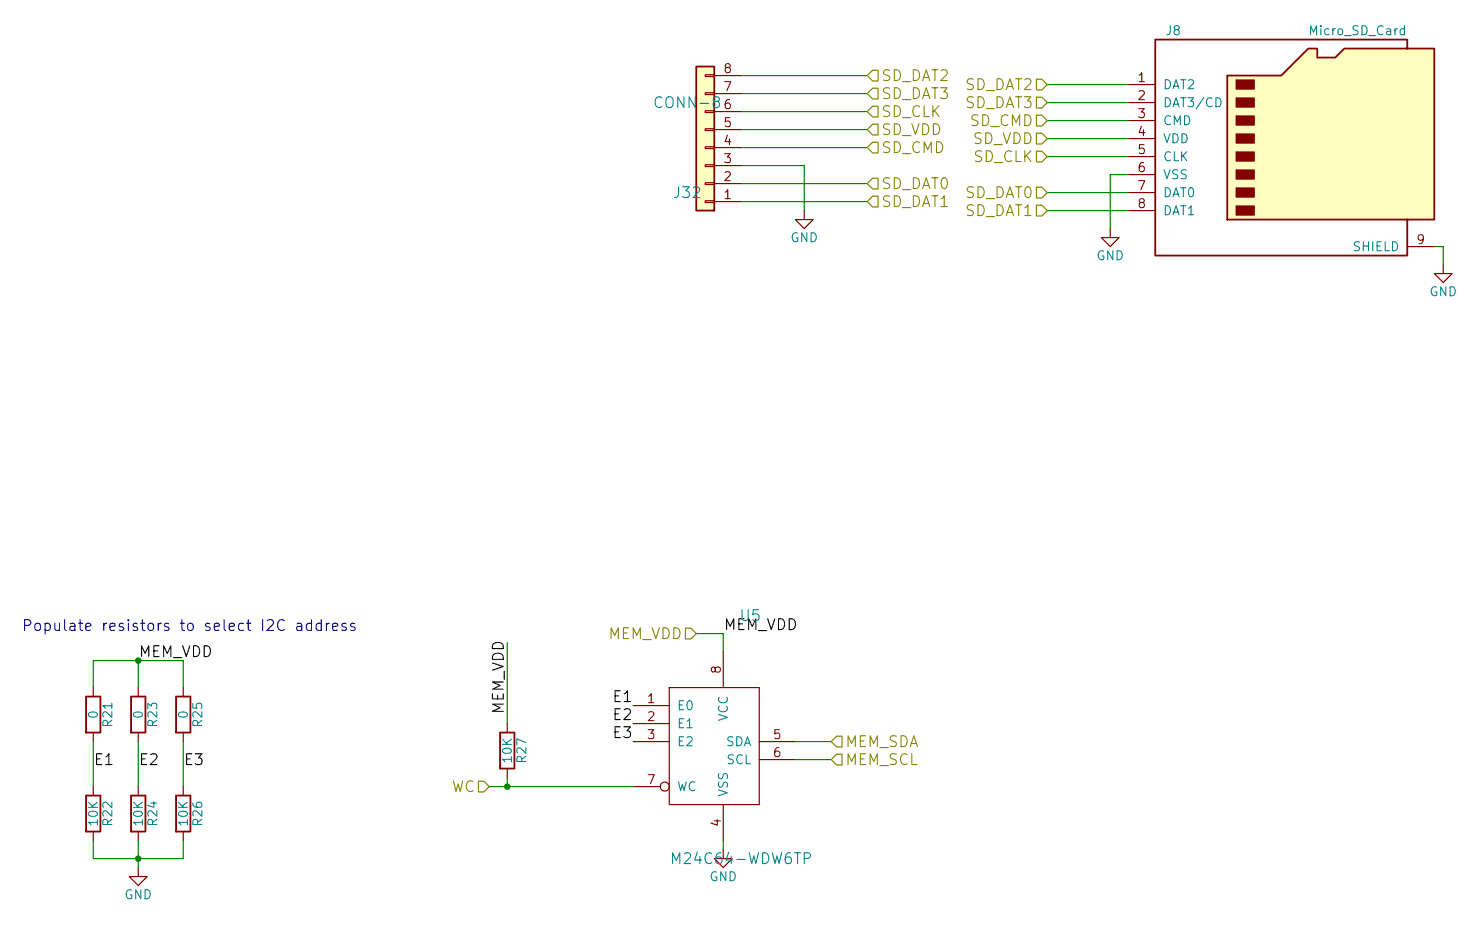
[picture p28: schematic MEMORY.sch]

Parts:
J8: Micro_SD_Card; micro_sd; part_num MEMM-002
J32: CONN-8; PinHeader_1x08_P2.54mm_Vertical; part_num CONN-008
R21, R23, R25: 0; R_0603_1608Metric_Pad0.84x1.00mm_HandSolder; part_num RESS-001
R22, R24, R26, R27: 10K; R_0603_1608Metric_Pad0.84x1.00mm_HandSolder; part_num RESS-005
U5: M24C64-WDW6TP; TSSOP-8_4.4x3mm_P0.65mm; part_num MEMM-001

Connections:
/3V3: J8.4 (VDD), J32.5, R21.1, R23.1, R25.1, R27.1, U5.8 (VCC); also elsewhere on the board
/MEMORY/E1: R21.2, R22.1, U5.1 (E0)
/MEMORY/E2: R23.2, R24.1, U5.2 (E1)
/MEMORY/E3: R25.2, R26.1, U5.3 (E2)
/MEM_WC: R27.2, U5.7 (WC); also elsewhere on the board
/SCL1: U5.6 (SCL); also elsewhere on the board
/SDA1: U5.5 (SDA); also elsewhere on the board
/SD_CK: J8.5 (CLK), J32.6; also elsewhere on the board
/SD_CMD: J8.3 (CMD), J32.4; also elsewhere on the board
/SD_D0: J8.7 (DAT0), J32.2; also elsewhere on the board
/SD_D1: J8.8 (DAT1), J32.1; also elsewhere on the board
/SD_D2: J8.1 (DAT2), J32.8; also elsewhere on the board
/SD_D3: J8.2 (DAT3/CD), J32.7; also elsewhere on the board
GND: J8.6 (VSS), J8.9 (SHIELD), J32.3, R22.2, R24.2, R26.2, U5.4 (VSS); also elsewhere on the board

Notes on the sheet:
Populate resistors to select I2C address

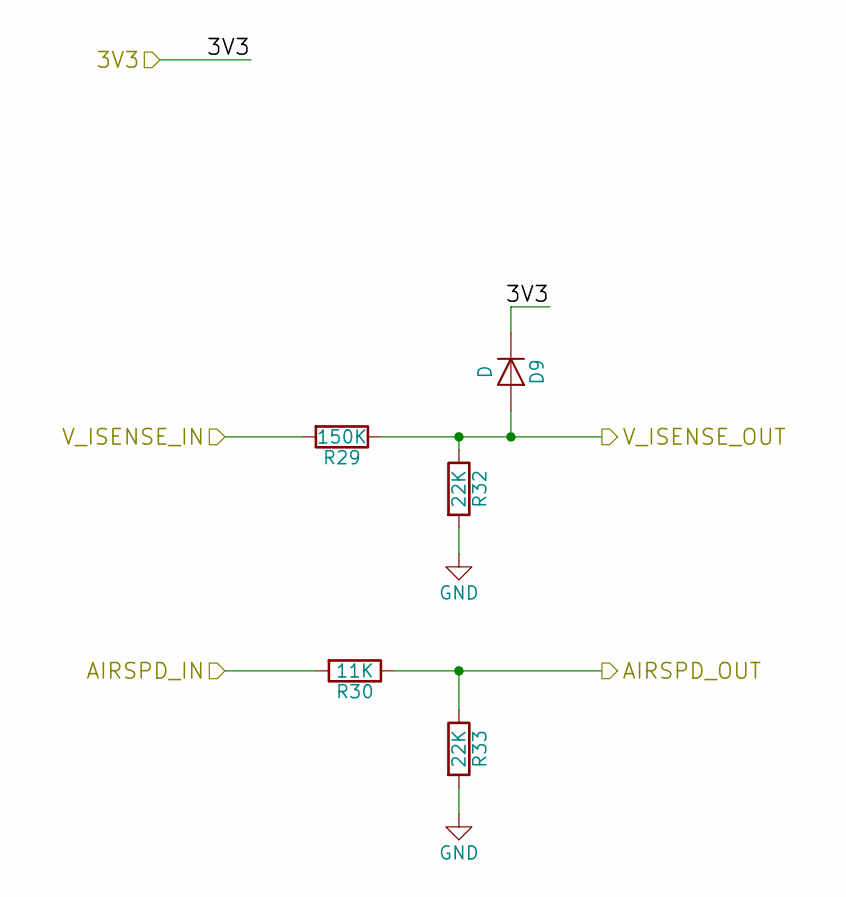
[picture p29: schematic ADC_voltage_dividers.sch]

Parts:
D9: D; D_PowerDI-123; part_num DIOD-007
R29: 150K; R_0603_1608Metric_Pad0.84x1.00mm_HandSolder; part_num RESS-007
R30: 11K; R_0603_1608Metric_Pad0.84x1.00mm_HandSolder; part_num RESS-004
R32, R33: 22K; R_0603_1608Metric_Pad0.84x1.00mm_HandSolder; part_num RESS-002

Connections:
/3V3: D9.1 (K); also elsewhere on the board
/AIRSPD_ADC: R30.1, R33.1; also elsewhere on the board
/AIR_SPD: R30.2; also elsewhere on the board
/V_ISENSE: R29.2; also elsewhere on the board
/V_ISENSE_ADC: D9.2 (A), R29.1, R32.1; also elsewhere on the board
GND: R32.2, R33.2; also elsewhere on the board

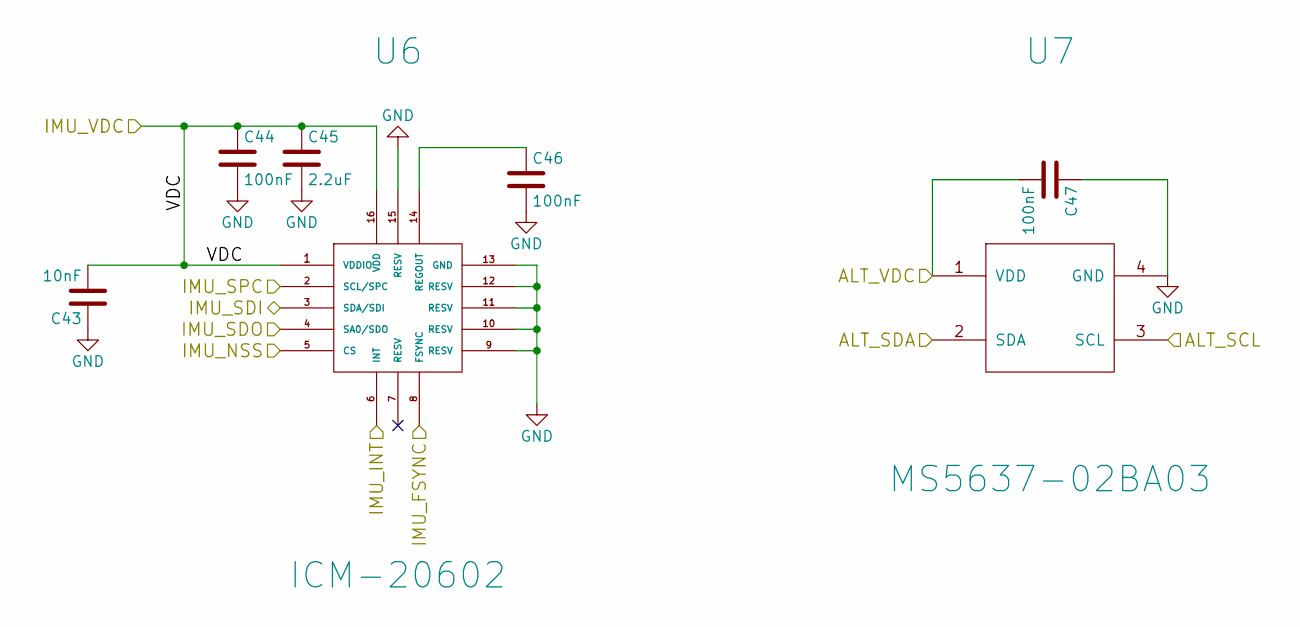
[picture p30: schematic SENSORS.sch]

Parts:
C43: 10nF; C_0603_1608Metric_Pad0.84x1.00mm_HandSolder; part_num CAPP-010
C44, C46, C47: 100nF; C_0603_1608Metric_Pad0.84x1.00mm_HandSolder; part_num CAPP-005
C45: 2.2uF; C_0603_1608Metric_Pad0.84x1.00mm_HandSolder; part_num CAPP-007
U6: ICM-20602; part_num SENS-001
U7: MS5637-02BA03; part_num SENS-002

Connections:
/3V3: C43.2, C44.1, C45.1, C47.2, U6.1 (VDDIO), U6.16 (VDD), U7.1 (VDD); also elsewhere on the board
/MISO1: U6.4 (SA0/SDO); also elsewhere on the board
/MOSI1: U6.3 (SDA/SDI); also elsewhere on the board
/NSS1: U6.5 (CS); also elsewhere on the board
/SCK1: U6.2 (SCL/SPC); also elsewhere on the board
/SCL2: U7.3 (SCL); also elsewhere on the board
/SDA2: U7.2 (SDA); also elsewhere on the board
/SENSORS/IMU_FSYNC: U6.8 (FSYNC); also elsewhere on the board
/SENSORS/IMU_INT: U6.6 (INT); also elsewhere on the board
GND: C43.1, C44.2, C45.2, C46.2, C47.1, U6.9 (RESV), U6.10 (RESV), U6.11 (RESV), U6.12 (RESV), U6.13 (GND), U6.15 (RESV), U7.4 (GND); also elsewhere on the board
unnamed: C46.1, U6.14 (REGOUT)

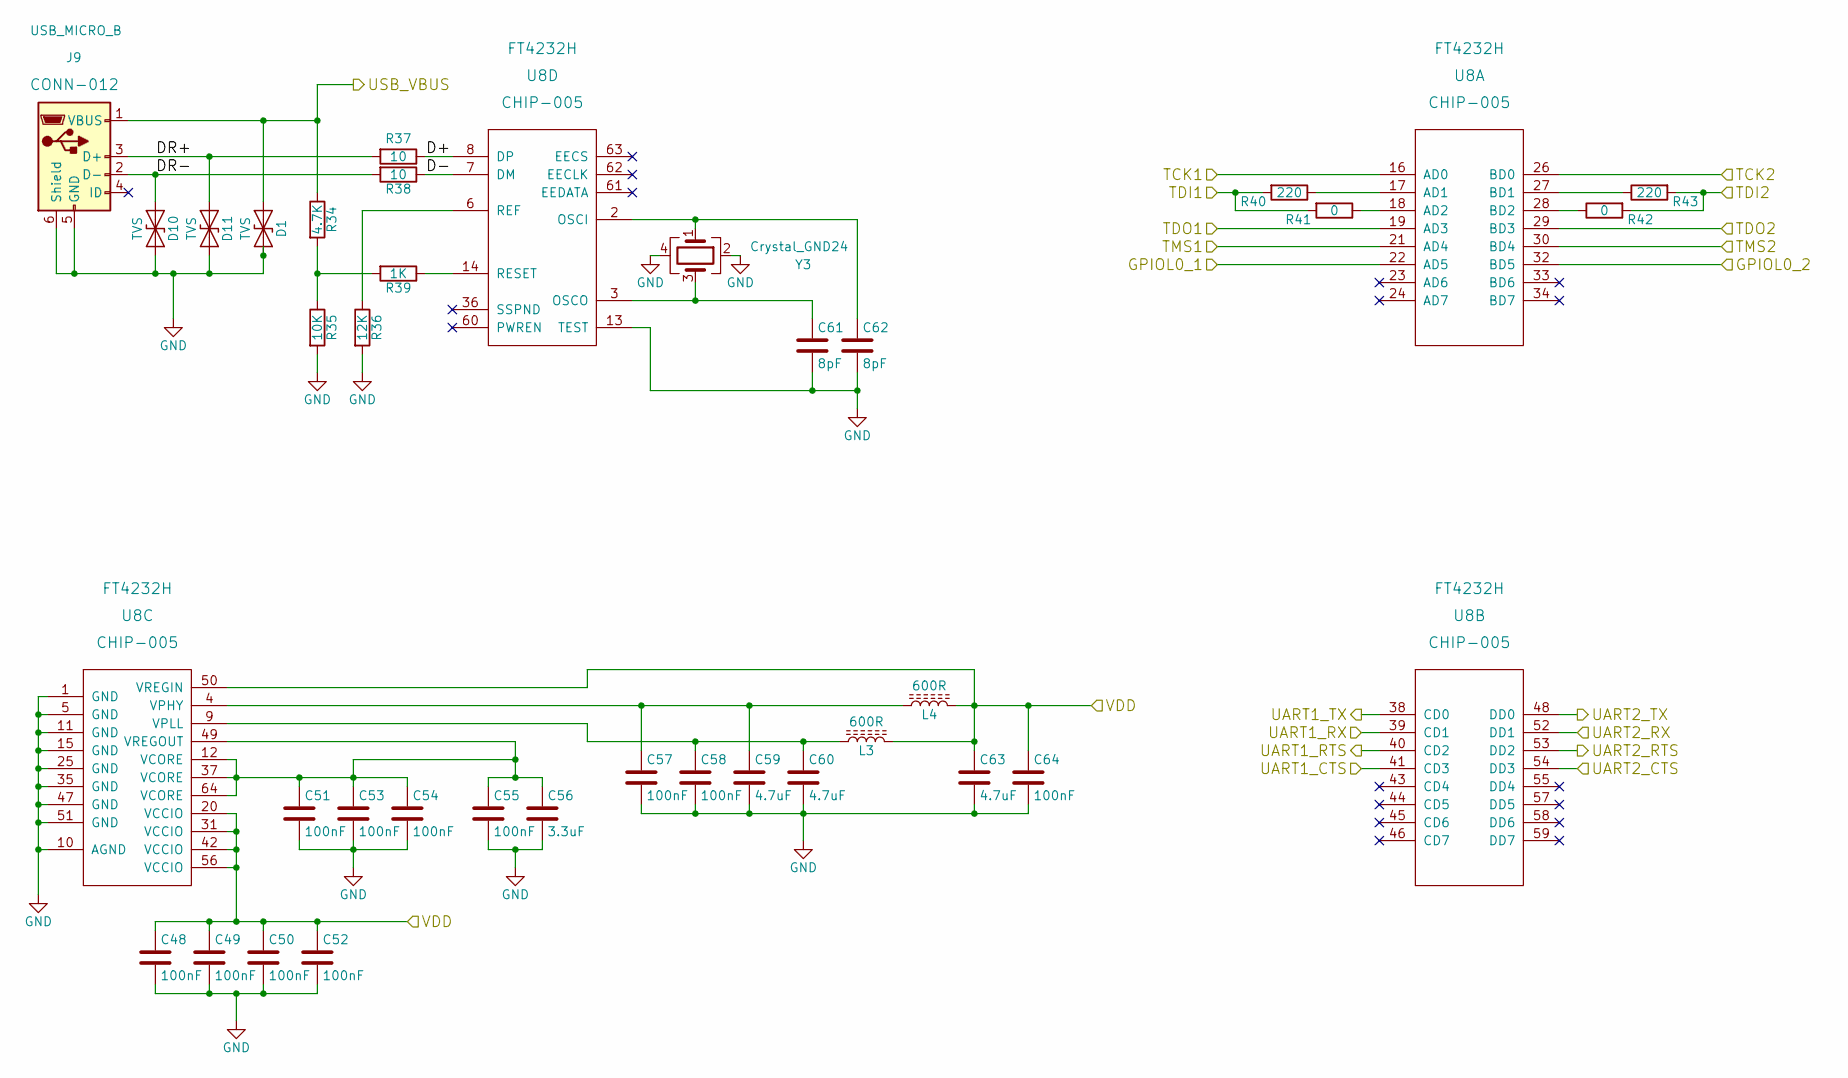
[picture p31: schematic USB INTERFACE.sch, USB INTERFACE (SWD/UART)]

Parts:
C48, C49, C50, C51, C52, C53, C54, C55, C57, C58, C64: 100nF; C_0603_1608Metric_Pad0.84x1.00mm_HandSolder; part_num CAPP-005
C56: 3.3uF; C_0603_1608Metric_Pad0.84x1.00mm_HandSolder; part_num CAPP-015
C59, C60, C63: 4.7uF; C_0603_1608Metric_Pad0.84x1.00mm_HandSolder; part_num CAPP-006
C61, C62: 8pF; C_0603_1608Metric_Pad0.84x1.00mm_HandSolder; part_num CAPP-011
D1, D10, D11: TVS; D_0603_1608Metric_Pad0.67x1.00mm_HandSolder; part_num DIOD-006
J9: USB_MICRO_B; USB_Micro-B_10118194-0001LF; part_num CONN-012
L3, L4: 600R; L_0603_HandSoldering; part_num INDU-004
R34: 4.7K; R_0603_1608Metric_Pad0.84x1.00mm_HandSolder; part_num RESS-015
R35: 10K; R_0603_1608Metric_Pad0.84x1.00mm_HandSolder; part_num RESS-005
R36: 12K; R_0603_1608Metric_Pad0.84x1.00mm_HandSolder; part_num RESS-016
R37, R38: 10; R_0603_1608Metric_Pad0.84x1.00mm_HandSolder; part_num RESS-018
R39: 1K; R_0603_1608Metric_Pad0.84x1.00mm_HandSolder; part_num RESS-017
R40, R43: 220; R_0603_1608Metric_Pad0.84x1.00mm_HandSolder; part_num RESS-014
R41, R42: 0; R_0603_1608Metric_Pad0.84x1.00mm_HandSolder; part_num RESS-001
U8: FT4232H; LQFP-64_10x10mm_P0.5mm; part_num CHIP-005
Y3: Crystal_GND24; Crystal_SMD_2520-4Pin_2.5x2.0mm; part_num XTAL-003

Connections:
/3V3: C48.1, C49.1, C50.1, C52.1, C63.1, C64.1, L3.2, L4.2, U8.20 (VCCIO), U8.31 (VCCIO), U8.42 (VCCIO), U8.50 (VREGIN), U8.56 (VCCIO); also elsewhere on the board
/5V_USB: D1.1 (A1), J9.1 (VBUS), R34.1; also elsewhere on the board
/NRST_PILOT: U8.32 (BD5); also elsewhere on the board
/NRST_SAFETY: U8.22 (AD5); also elsewhere on the board
/RX3: U8.52 (DD1); also elsewhere on the board
/SAFETY_DBG_RX: U8.38 (CD0); also elsewhere on the board
/SAFETY_DBG_TX: U8.39 (CD1); also elsewhere on the board
/SCLK_PILOT: U8.26 (BD0); also elsewhere on the board
/SCLK_SAFETY: U8.16 (AD0); also elsewhere on the board
/SWIO_PILOT: R42.2, R43.2; also elsewhere on the board
/SWIO_SAFETY: R40.2, R41.2; also elsewhere on the board
/TDO1_TST: U8.19 (AD3); also elsewhere on the board
/TDO2_TST: U8.29 (BD3); also elsewhere on the board
/TMS1_TST: U8.21 (AD4); also elsewhere on the board
/TMS2_TST: U8.30 (BD4); also elsewhere on the board
/TX3: U8.48 (DD0); also elsewhere on the board
/UART1_CTS_TST: U8.41 (CD3); also elsewhere on the board
/UART1_RTS_TST: U8.40 (CD2); also elsewhere on the board
/UART2_CTS_TST: U8.54 (DD3); also elsewhere on the board
/UART2_RTS_TST: U8.53 (DD2); also elsewhere on the board
/USB Interface/D+: R37.1, U8.8 (DP)
/USB Interface/D-: R38.1, U8.7 (DM)
/USB Interface/DR+: D11.1 (A1), J9.3 (D+), R37.2
/USB Interface/DR-: D10.1 (A1), J9.2 (D-), R38.2
GND: C48.2, C49.2, C50.2, C51.2, C52.2, C53.2, C54.2, C55.2, C56.2, C57.2, C58.2, C59.2, C60.2, C61.2, C62.2, C63.2, C64.2, D1.2 (A2), D10.2 (A2), D11.2 (A2), J9.5 (GND), J9.6 (Shield), R35.2, R36.2, U8.1 (GND), U8.5 (GND), U8.10 (AGND), U8.11 (GND), U8.13 (TEST), U8.15 (GND), U8.25 (GND), U8.35 (GND), U8.47 (GND), U8.51 (GND), Y3.2, Y3.4; also elsewhere on the board
unnamed: C51.1, C53.1, C54.1, C55.1, C56.1, U8.12 (VCORE), U8.37 (VCORE), U8.49 (VREGOUT), U8.64 (VCORE)
unnamed: C57.1, C59.1, L4.1, U8.4 (VPHY)
unnamed: C58.1, C60.1, L3.1, U8.9 (VPLL)
unnamed: C61.1, U8.3 (OSCO), Y3.3
unnamed: C62.1, U8.2 (OSCI), Y3.1
unnamed: R34.2, R35.1, R39.2
unnamed: R36.1, U8.6 (REF)
unnamed: R39.1, U8.14 (RESET)
unnamed: R40.1, U8.17 (AD1)
unnamed: R41.1, U8.18 (AD2)
unnamed: R42.1, U8.28 (BD2)
unnamed: R43.1, U8.27 (BD1)

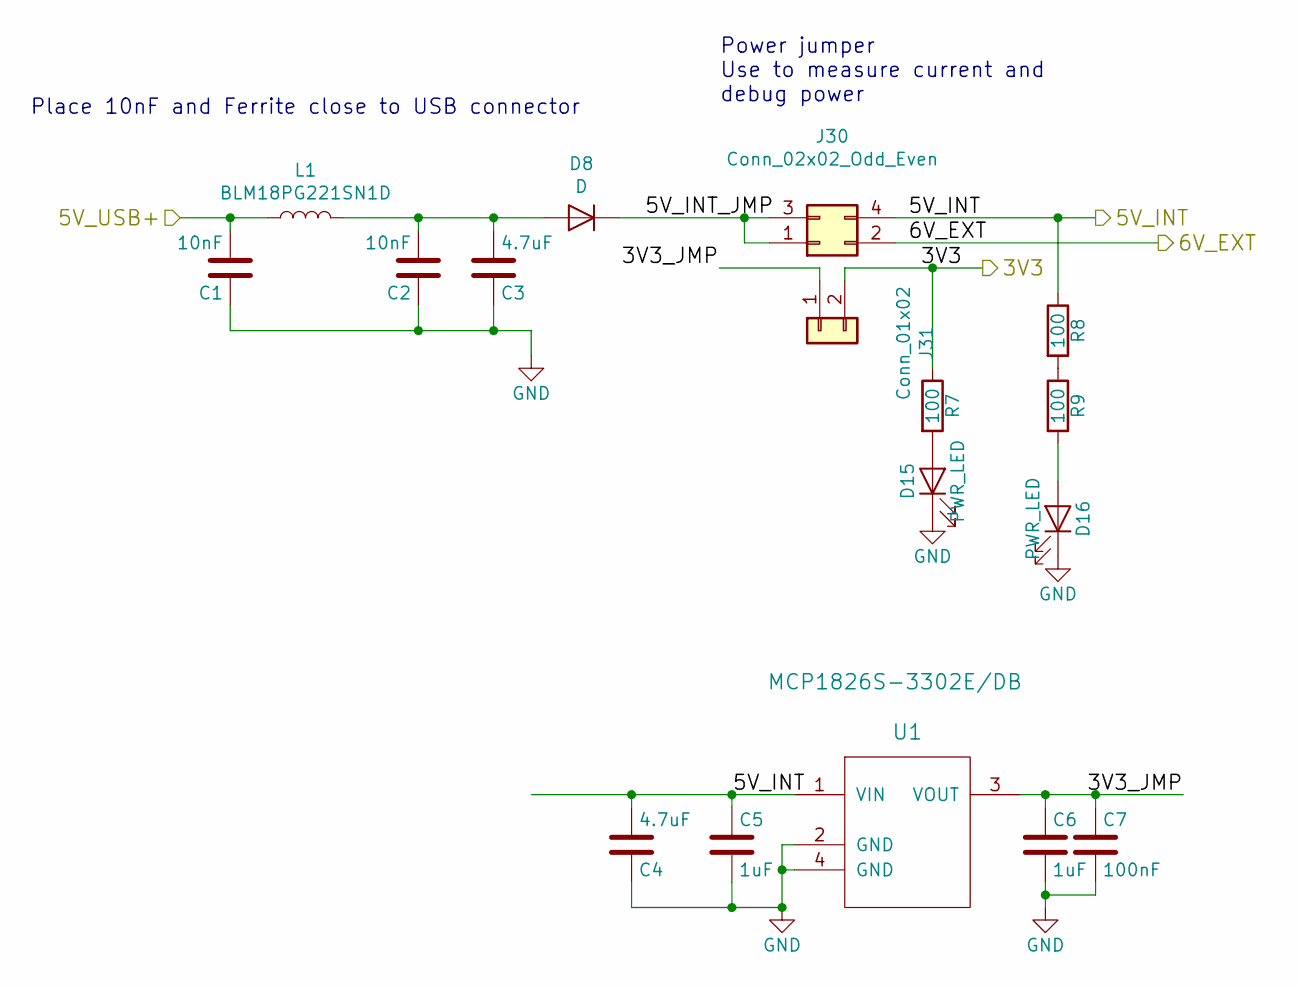
[picture p32: schematic POWER.sch]

Parts:
C1, C2: 10nF; C_0603_1608Metric_Pad0.84x1.00mm_HandSolder; part_num CAPP-010
C3, C4: 4.7uF; C_0603_1608Metric_Pad0.84x1.00mm_HandSolder; part_num CAPP-006
C5, C6: 1uF; C_0603_1608Metric_Pad0.84x1.00mm_HandSolder; part_num CAPP-004
C7: 100nF; C_0603_1608Metric_Pad0.84x1.00mm_HandSolder; part_num CAPP-005
D8: D; D_PowerDI-123; part_num DIOD-007
D15, D16: PWR_LED; LED_0603_1608Metric_Pad0.67x1.00mm_HandSolder; part_num DIOD-003
J30: Conn_02x02_Odd_Even; PinSocket_2x02_P2.54mm_Vertical; part_num CONN-008
J31: Conn_01x02; PinSocket_2x01_P2.54mm_Vertical; part_num CONN-008
L1: BLM18PG221SN1D; L_0603_HandSoldering
R7, R8, R9: 100; R_0603_1608Metric_Pad0.84x1.00mm_HandSolder; part_num RESS-006
U1: MCP1826S-3302E/DB; SOT-223; part_num REGU-002

Connections:
/3V3: J31.2, R7.1; also elsewhere on the board
/5V_INT: C4.2, C5.1, J30.4, R8.1, U1.1 (VIN); also elsewhere on the board
/5V_USB: C1.2, L1.1; also elsewhere on the board
/6V_EXT: J30.2; also elsewhere on the board
/POWER/3V3_JMP: C6.1, C7.1, J31.1, U1.3 (VOUT)
/POWER/5V_INT_JMP: D8.1 (K), J30.1, J30.3
GND: C1.1, C2.1, C3.1, C4.1, C5.2, C6.2, C7.2, D15.1 (K), D16.1 (K), U1.2 (GND), U1.4 (GND); also elsewhere on the board
unnamed: C2.2, C3.2, D8.2 (A), L1.2
unnamed: D15.2 (A), R7.2
unnamed: D16.2 (A), R9.2
unnamed: R8.2, R9.1

Notes on the sheet:
Power jumper Use to measure current and debug power
Place 10nF and Ferrite close to USB connector

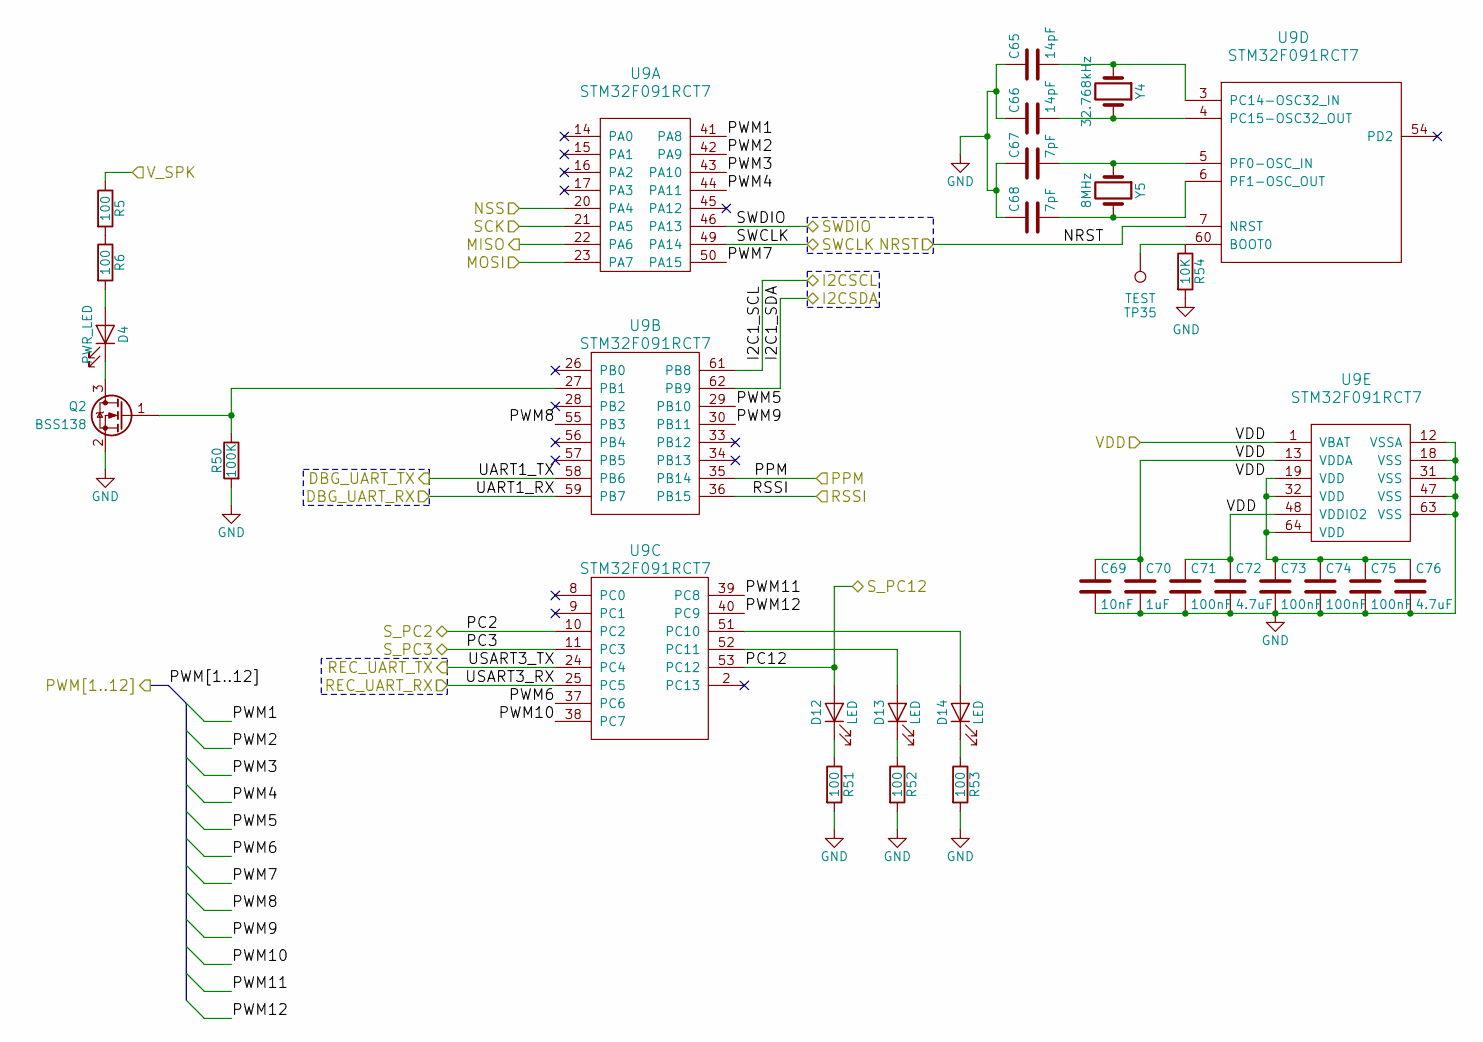
[picture p33: schematic STM32F0 RELAY.sch, Safety Switch Controller/ PPM Converter]

Parts:
C65, C66: 14pF; C_0603_1608Metric_Pad0.84x1.00mm_HandSolder; part_num CAPP-008
C67, C68: 7pF; C_0603_1608Metric_Pad0.84x1.00mm_HandSolder; part_num CAPP-009
C69: 10nF; C_0603_1608Metric_Pad0.84x1.00mm_HandSolder; part_num CAPP-010
C70: 1uF; C_0603_1608Metric_Pad0.84x1.00mm_HandSolder; part_num CAPP-004
C71, C73, C74, C75: 100nF; C_0603_1608Metric_Pad0.84x1.00mm_HandSolder; part_num CAPP-005
C72, C76: 4.7uF; C_0603_1608Metric_Pad0.84x1.00mm_HandSolder; part_num CAPP-006
D4: PWR_LED; LED_0603_1608Metric_Pad0.67x1.00mm_HandSolder; part_num DIOD-003
D12, D13, D14: LED; LED_0603_1608Metric_Pad0.67x1.00mm_HandSolder; part_num DIOD-002
Q2: BSS138; TSOT-23; part_num TRAN-002
R5, R6, R51, R52, R53: 100; R_0603_1608Metric_Pad0.84x1.00mm_HandSolder; part_num RESS-006
R50: 100K; R_0603_1608Metric_Pad0.84x1.00mm_HandSolder; part_num RESS-008
R54: 10K; R_0603_1608Metric_Pad0.84x1.00mm_HandSolder; part_num RESS-005
TP35: TEST; TestPoint_Pad_D1.5mm
U9: STM32F091RCT7; LQFP-64_10x10mm_P0.5mm; part_num CHIP-008
Y4: 32.768kHz; Crystal_SMD_MicroCrystal_CC7V-T1A-2Pin_3.2x1.5mm; part_num XTAL-001
Y5: 8MHz; Crystal_SMD_5032-2Pin_5.0x3.2mm_HandSoldering; part_num XTAL-002

Connections:
/3V3: C69.1, C70.1, C71.1, C72.1, C73.1, C74.1, C75.1, C76.1, U9.1 (VBAT), U9.13 (VDDA), U9.19 (VDD), U9.32 (VDD), U9.48 (VDDIO2), U9.64 (VDD); also elsewhere on the board
/5V_INT: R5.1; also elsewhere on the board
/MISO6: U9.22 (PA6); also elsewhere on the board
/MOSI6: U9.23 (PA7); also elsewhere on the board
/NRST_SAFETY: U9.7 (NRST); also elsewhere on the board
/NSS6: U9.20 (PA4); also elsewhere on the board
/PPM: U9.35 (PB14); also elsewhere on the board
/PWM 1-12/PWM1: U9.41 (PA8); also elsewhere on the board
/PWM 1-12/PWM2: U9.42 (PA9); also elsewhere on the board
/PWM 1-12/PWM3: U9.43 (PA10); also elsewhere on the board
/PWM 1-12/PWM4: U9.44 (PA11); also elsewhere on the board
/PWM 1-12/PWM5: U9.29 (PB10); also elsewhere on the board
/PWM 1-12/PWM6: U9.37 (PC6); also elsewhere on the board
/PWM 1-12/PWM7: U9.50 (PA15); also elsewhere on the board
/PWM 1-12/PWM8: U9.55 (PB3); also elsewhere on the board
/PWM 1-12/PWM9: U9.30 (PB11); also elsewhere on the board
/PWM 1-12/PWM10: U9.38 (PC7); also elsewhere on the board
/PWM 1-12/PWM11: U9.39 (PC8); also elsewhere on the board
/PWM 1-12/PWM12: U9.40 (PC9); also elsewhere on the board
/RSSI: U9.36 (PB15); also elsewhere on the board
/SAFETY_DBG_RX: U9.59 (PB7); also elsewhere on the board
/SAFETY_DBG_TX: U9.58 (PB6); also elsewhere on the board
/SCK6: U9.21 (PA5); also elsewhere on the board
/SCL1: U9.61 (PB8); also elsewhere on the board
/SCLK_SAFETY: U9.49 (PA14); also elsewhere on the board
/SDA1: U9.62 (PB9); also elsewhere on the board
/SWIO_SAFETY: U9.46 (PA13); also elsewhere on the board
/S_PC2: U9.10 (PC2); also elsewhere on the board
/S_PC3: U9.11 (PC3); also elsewhere on the board
/S_PC12: D12.2 (A), U9.53 (PC12); also elsewhere on the board
/UHF_RX: U9.25 (PC5); also elsewhere on the board
/UHF_TX: U9.24 (PC4); also elsewhere on the board
GND: C65.1, C66.1, C67.1, C68.1, C69.2, C70.2, C71.2, C72.2, C73.2, C74.2, C75.2, C76.2, Q2.2 (S), R50.2, R51.2, R52.2, R53.2, R54.2, U9.12 (VSSA), U9.18 (VSS), U9.31 (VSS), U9.47 (VSS), U9.63 (VSS); also elsewhere on the board
unnamed: C65.2, U9.3 (PC14-OSC32_IN), Y4.1
unnamed: C66.2, U9.4 (PC15-OSC32_OUT), Y4.2
unnamed: C67.2, U9.5 (PF0-OSC_IN), Y5.1
unnamed: C68.2, U9.6 (PF1-OSC_OUT), Y5.2
unnamed: D4.1 (K), Q2.3 (D)
unnamed: D4.2 (A), R6.2
unnamed: D12.1 (K), R51.1
unnamed: D13.1 (K), R52.1
unnamed: D13.2 (A), U9.52 (PC11)
unnamed: D14.1 (K), R53.1
unnamed: D14.2 (A), U9.51 (PC10)
unnamed: Q2.1 (G), R50.1, U9.27 (PB1)
unnamed: R5.2, R6.1
unnamed: R54.1, TP35.1, U9.60 (BOOT0)
