UWARG/ZP-breakout/Hardware/ZP-Breakout.kicad_pcb

## KiCad design Hardware/ZP-Breakout.kicad_pcb (continued)

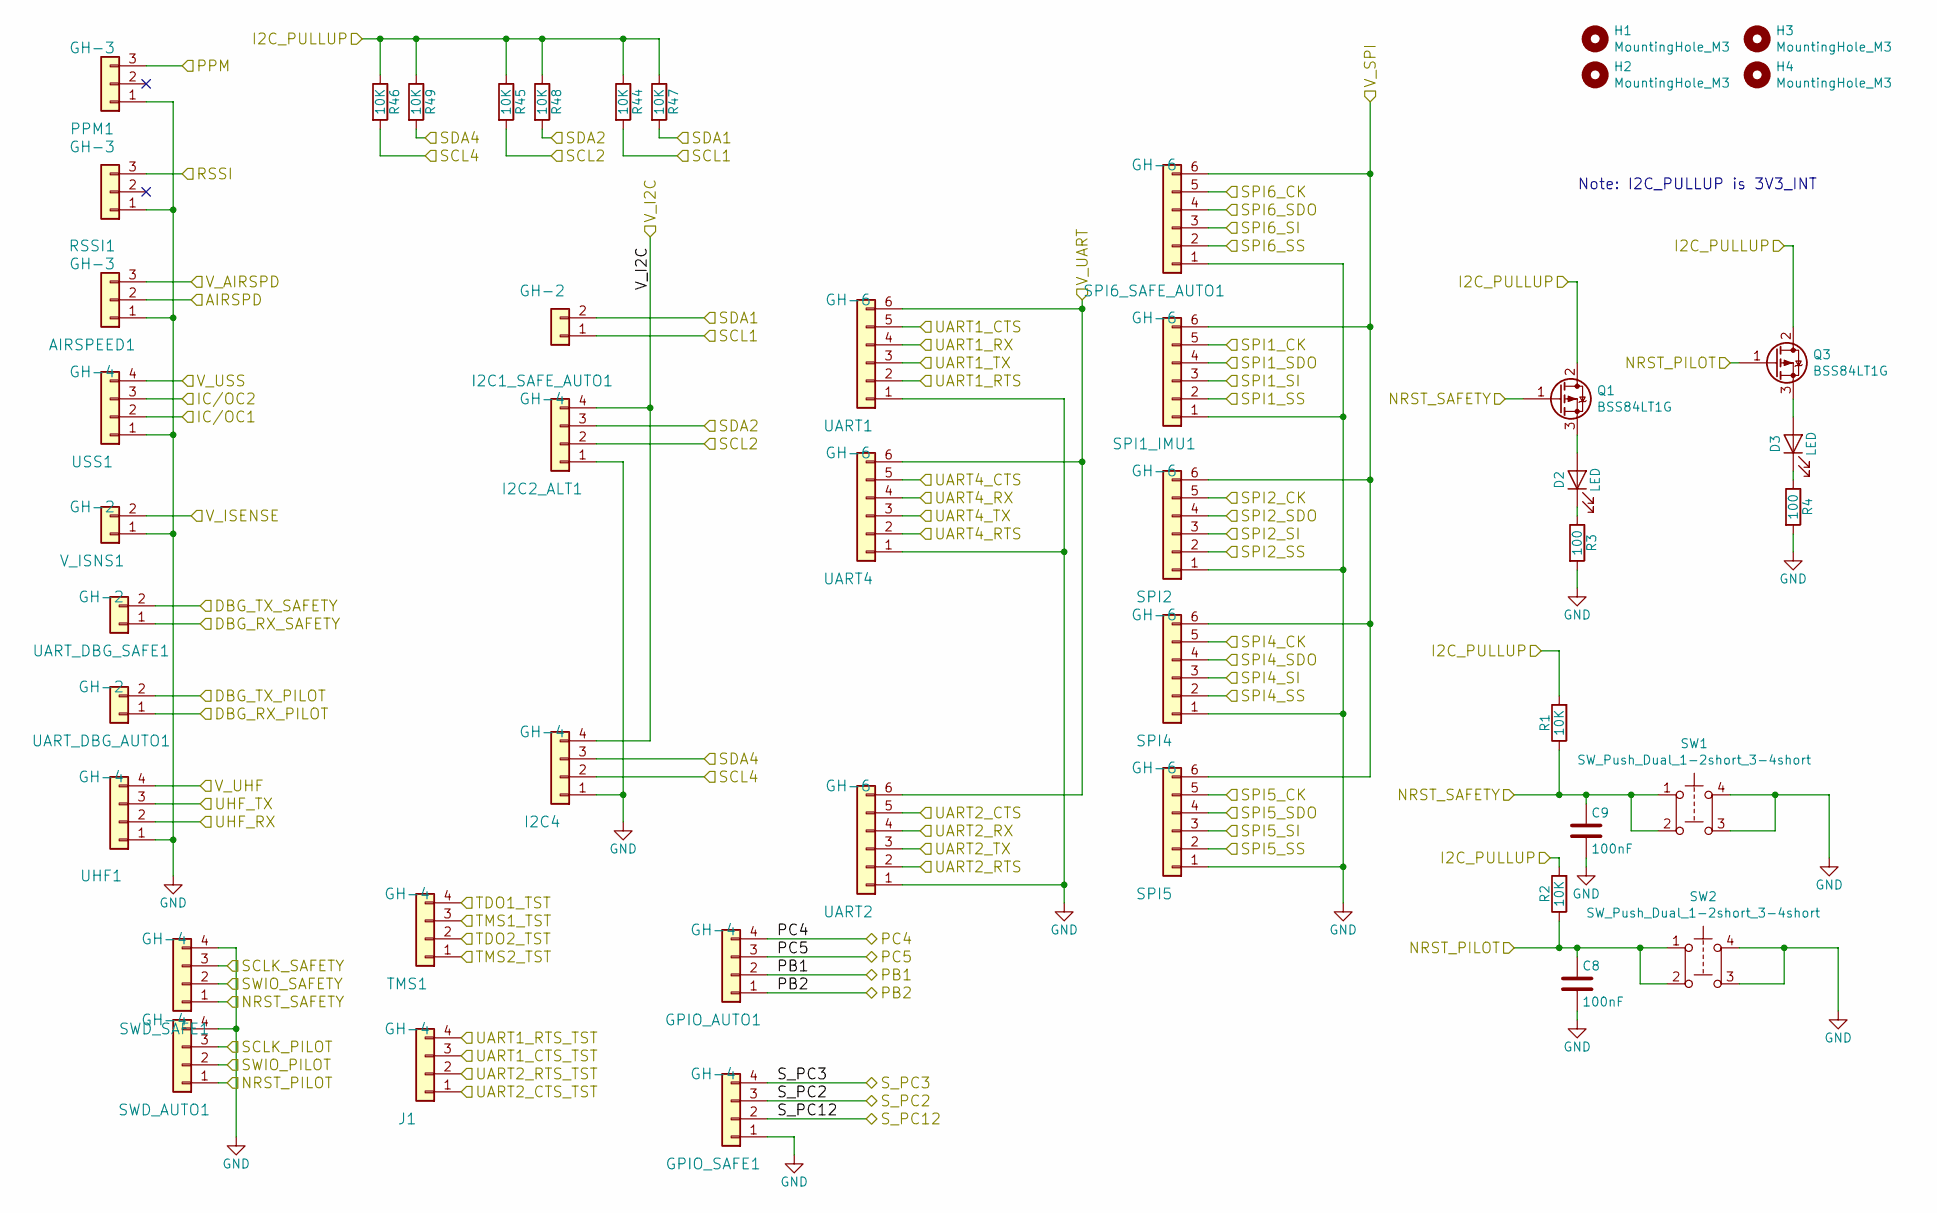
[picture p34: schematic HEADERS.sch]

Parts:
AIRSPEED1: GH-3; PinHeader_1x03_P2.54mm_Vertical; part_num CONN-007
C8, C9: 100nF; C_0603_1608Metric_Pad0.84x1.00mm_HandSolder; part_num CAPP-005
D2, D3: LED; LED_0603_1608Metric_Pad0.67x1.00mm_HandSolder; part_num DIOD-002
GPIO_AUTO1: GH-4; PinHeader_1x04_P2.54mm_Vertical; part_num CONN-008
GPIO_SAFE1: GH-4; PinHeader_1x04_P2.54mm_Vertical; part_num CONN-008
H1, H2, H3, H4: MountingHole_M3; MountingHole_3.2mm_M3_ISO14580_Pad
I2C1_SAFE_AUTO1: GH-2; PinHeader_1x02_P2.54mm_Vertical; part_num CONN-008
I2C2_ALT1, I2C4: GH-4; PinHeader_1x04_P2.54mm_Vertical; part_num CONN-008
J1: GH-4; PinHeader_1x04_P2.54mm_Vertical; part_num CONN-008
PPM1: GH-3; PinHeader_1x03_P2.54mm_Vertical; part_num CONN-007
Q1, Q3: BSS84LT1G; SOT-23; part_num TRAN-005
R1, R2, R44, R45, R46, R47, R48, R49: 10K; R_0603_1608Metric_Pad0.84x1.00mm_HandSolder; part_num RESS-005
R3, R4: 100; R_0603_1608Metric_Pad0.84x1.00mm_HandSolder; part_num RESS-006
RSSI1: GH-3; PinHeader_1x03_P2.54mm_Vertical; part_num CONN-009
SPI1_IMU1, SPI2, SPI4, SPI5, SPI6_SAFE_AUTO1: GH-6; PinHeader_1x06_P2.54mm_Vertical; part_num CONN-009
SW1, SW2: SW_Push_Dual_1-2short_3-4short; Button
SWD_AUTO1: GH-4; PinHeader_1x04_P2.54mm_Vertical; part_num CONN-009
SWD_SAFE1: GH-4; PinHeader_1x04_P2.54mm_Vertical; part_num CONN-009
TMS1: GH-4; PinHeader_1x04_P2.54mm_Vertical; part_num CONN-009
UART1, UART2, UART4: GH-6; PinHeader_1x06_P2.54mm_Vertical; part_num CONN-009
UART_DBG_AUTO1: GH-2; PinHeader_1x02_P2.54mm_Vertical; part_num CONN-006
UART_DBG_SAFE1: GH-2; PinHeader_1x02_P2.54mm_Vertical; part_num CONN-006
UHF1: GH-4; PinHeader_1x04_P2.54mm_Vertical; part_num CONN-008
USS1: GH-4; PinHeader_1x04_P2.54mm_Vertical; part_num CONN-008
V_ISNS1: GH-2; PinHeader_1x02_P2.54mm_Vertical; part_num CONN-006

Connections:
/3V3: Q1.2 (D), Q3.2 (D), R1.2, R2.2, R44.1, R45.1, R46.1, R47.1, R48.1, R49.1; also elsewhere on the board
/5V_INT: AIRSPEED1.3, I2C2_ALT1.4, I2C4.4, SPI1_IMU1.6, SPI2.6, SPI4.6, SPI5.6, SPI6_SAFE_AUTO1.6, UART1.6, UART2.6, UART4.6, USS1.4; also elsewhere on the board
/6V_EXT: UHF1.4; also elsewhere on the board
/AIR_SPD: AIRSPEED1.2; also elsewhere on the board
/CTS1: UART1.5; also elsewhere on the board
/CTS2: UART2.5; also elsewhere on the board
/CTS4: UART4.5; also elsewhere on the board
/MISO1: SPI1_IMU1.4; also elsewhere on the board
/MISO2: SPI2.4; also elsewhere on the board
/MISO4: SPI4.4; also elsewhere on the board
/MISO5: SPI5.4; also elsewhere on the board
/MISO6: SPI6_SAFE_AUTO1.4; also elsewhere on the board
/MOSI1: SPI1_IMU1.3; also elsewhere on the board
/MOSI2: SPI2.3; also elsewhere on the board
/MOSI4: SPI4.3; also elsewhere on the board
/MOSI5: SPI5.3; also elsewhere on the board
/MOSI6: SPI6_SAFE_AUTO1.3; also elsewhere on the board
/NRST_PILOT: C8.1, Q3.1 (G), R2.1, SW2.1, SW2.2, SWD_AUTO1.1; also elsewhere on the board
/NRST_SAFETY: C9.1, Q1.1 (G), R1.1, SW1.1, SW1.2, SWD_SAFE1.1; also elsewhere on the board
/NSS1: SPI1_IMU1.2; also elsewhere on the board
/NSS2: SPI2.2; also elsewhere on the board
/NSS4: SPI4.2; also elsewhere on the board
/NSS5: SPI5.2; also elsewhere on the board
/NSS6: SPI6_SAFE_AUTO1.2; also elsewhere on the board
/PB1: GPIO_AUTO1.2; also elsewhere on the board
/PB2: GPIO_AUTO1.1; also elsewhere on the board
/PC4: GPIO_AUTO1.4; also elsewhere on the board
/PC5: GPIO_AUTO1.3; also elsewhere on the board
/PPM: PPM1.3; also elsewhere on the board
/RSSI: RSSI1.3; also elsewhere on the board
/RTS1: UART1.2; also elsewhere on the board
/RTS2: UART2.2; also elsewhere on the board
/RTS4: UART4.2; also elsewhere on the board
/RX1: UART1.4; also elsewhere on the board
/RX2: UART2.4; also elsewhere on the board
/RX3: UART_DBG_AUTO1.1; also elsewhere on the board
/RX4: UART4.4; also elsewhere on the board
/SAFETY_DBG_RX: UART_DBG_SAFE1.1; also elsewhere on the board
/SAFETY_DBG_TX: UART_DBG_SAFE1.2; also elsewhere on the board
/SCK1: SPI1_IMU1.5; also elsewhere on the board
/SCK2: SPI2.5; also elsewhere on the board
/SCK4: SPI4.5; also elsewhere on the board
/SCK5: SPI5.5; also elsewhere on the board
/SCK6: SPI6_SAFE_AUTO1.5; also elsewhere on the board
/SCL1: I2C1_SAFE_AUTO1.1, R44.2; also elsewhere on the board
/SCL2: I2C2_ALT1.2, R45.2; also elsewhere on the board
/SCL4: I2C4.2, R46.2; also elsewhere on the board
/SCLK_PILOT: SWD_AUTO1.3; also elsewhere on the board
/SCLK_SAFETY: SWD_SAFE1.3; also elsewhere on the board
/SDA1: I2C1_SAFE_AUTO1.2, R47.2; also elsewhere on the board
/SDA2: I2C2_ALT1.3, R48.2; also elsewhere on the board
/SDA4: I2C4.3, R49.2; also elsewhere on the board
/SWIO_PILOT: SWD_AUTO1.2; also elsewhere on the board
/SWIO_SAFETY: SWD_SAFE1.2; also elsewhere on the board
/S_PC2: GPIO_SAFE1.3; also elsewhere on the board
/S_PC3: GPIO_SAFE1.4; also elsewhere on the board
/S_PC12: GPIO_SAFE1.2; also elsewhere on the board
/TX1: UART1.3; also elsewhere on the board
/TX2: UART2.3; also elsewhere on the board
/TX3: UART_DBG_AUTO1.2; also elsewhere on the board
/TX4: UART4.3; also elsewhere on the board
/UART1_CTS_TST: J1.3; also elsewhere on the board
/UART1_RTS_TST: J1.4; also elsewhere on the board
/UART2_CTS_TST: J1.1; also elsewhere on the board
/UART2_RTS_TST: J1.2; also elsewhere on the board
/UHF_RX: UHF1.2; also elsewhere on the board
/UHF_TX: UHF1.3; also elsewhere on the board
/ULTRA_SONIC_1: USS1.2; also elsewhere on the board
/ULTRA_SONIC_2: USS1.3; also elsewhere on the board
/V_ISENSE: V_ISNS1.2; also elsewhere on the board
GND: AIRSPEED1.1, C8.2, C9.2, GPIO_SAFE1.1, I2C2_ALT1.1, I2C4.1, PPM1.1, R3.2, R4.2, RSSI1.1, SPI1_IMU1.1, SPI2.1, SPI4.1, SPI5.1, SPI6_SAFE_AUTO1.1, SW1.3, SW1.4, SW2.3, SW2.4, SWD_AUTO1.4, SWD_SAFE1.4, UART1.1, UART2.1, UART4.1, UHF1.1, USS1.1, V_ISNS1.1; also elsewhere on the board
unnamed: D2.1 (K), R3.1
unnamed: D2.2 (A), Q1.3 (S)
unnamed: D3.1 (K), R4.1
unnamed: D3.2 (A), Q3.3 (S)

Notes on the sheet:
Note: I2C_PULLUP is 3V3_INT

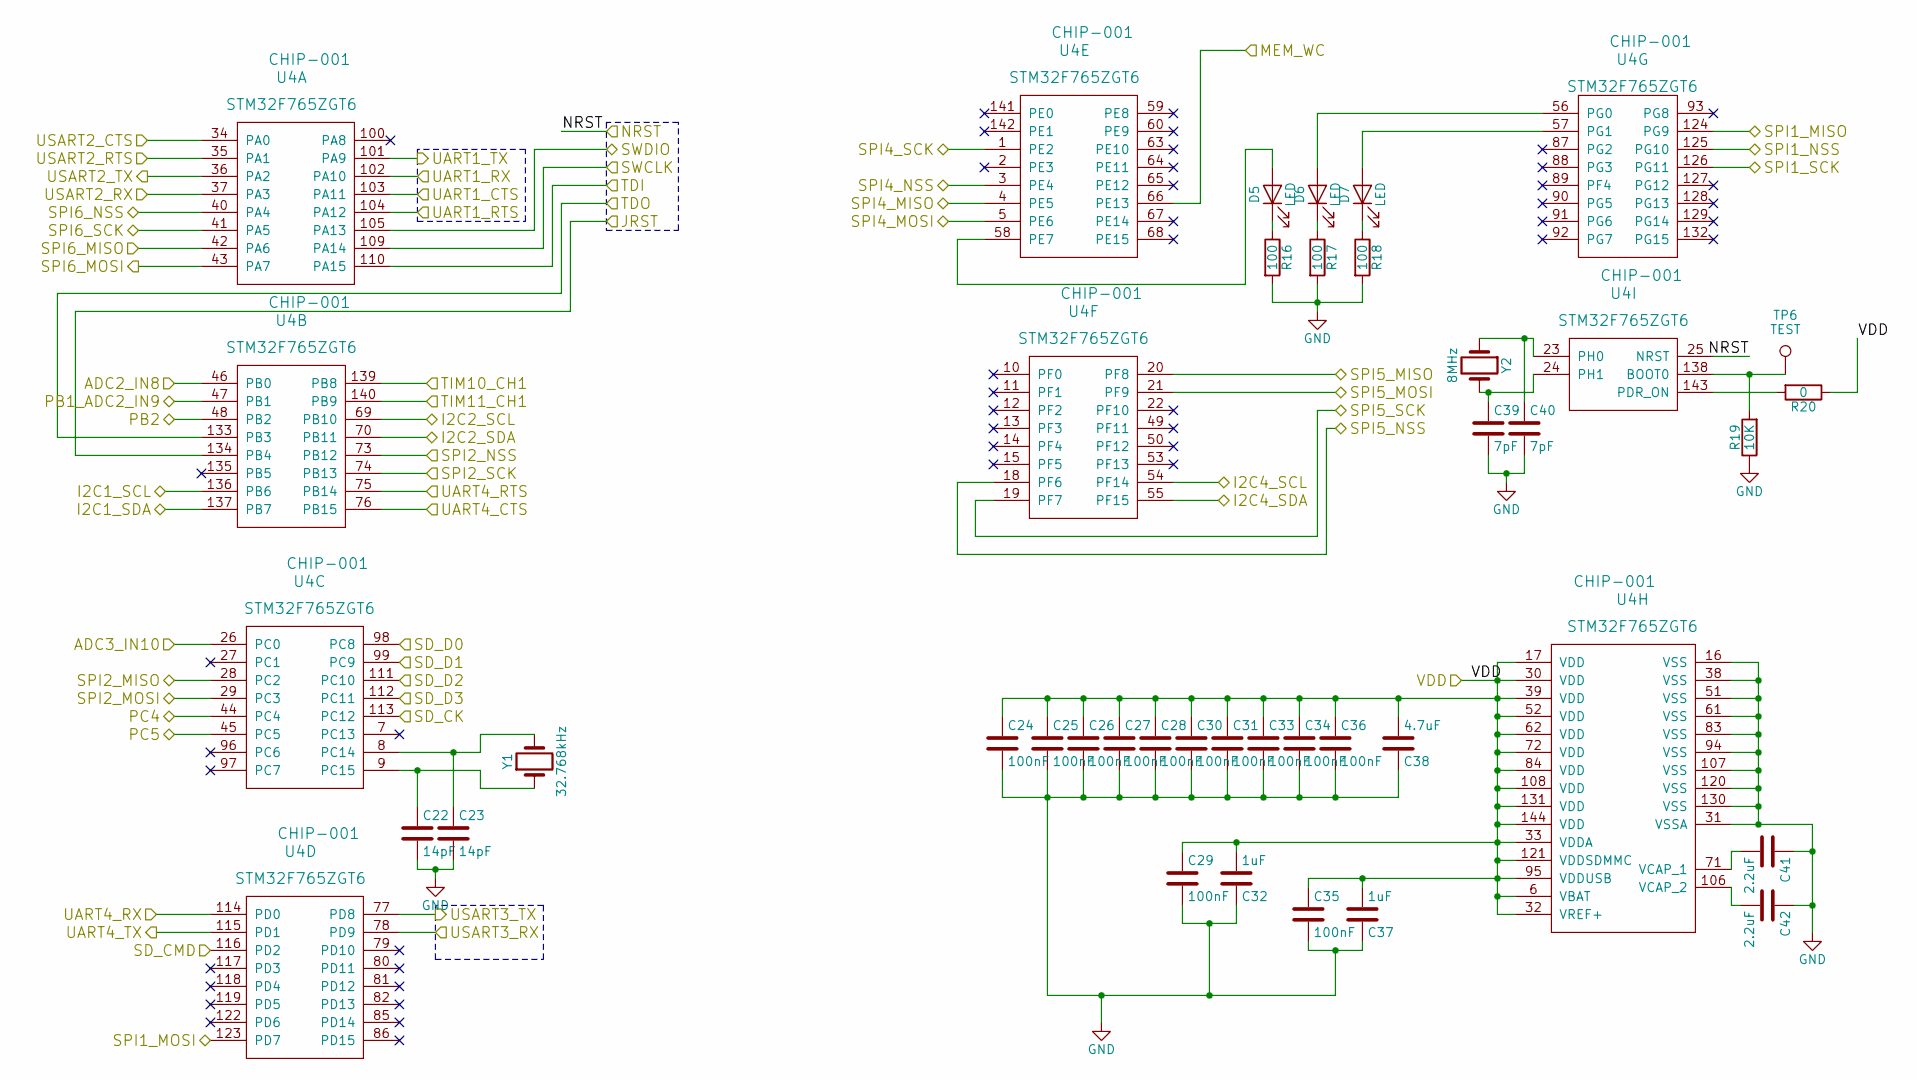
[picture p35: schematic STM32F7 IO.sch, Autopilot Controller I/O]

Parts:
C22, C23: 14pF; C_0603_1608Metric_Pad0.84x1.00mm_HandSolder; part_num CAPP-008
C24, C25, C26, C27, C28, C29, C30, C31, C33, C34, C35, C36: 100nF; C_0603_1608Metric_Pad0.84x1.00mm_HandSolder; part_num CAPP-005
C32, C37: 1uF; C_0603_1608Metric_Pad0.84x1.00mm_HandSolder; part_num CAPP-004
C38: 4.7uF; C_0603_1608Metric_Pad0.84x1.00mm_HandSolder; part_num CAPP-006
C39, C40: 7pF; C_0603_1608Metric_Pad0.84x1.00mm_HandSolder; part_num CAPP-009
C41, C42: 2.2uF; C_0603_1608Metric_Pad0.84x1.00mm_HandSolder; part_num CAPP-007
D5, D6, D7: LED; LED_0603_1608Metric_Pad0.67x1.00mm_HandSolder; part_num DIOD-002
R16, R17, R18: 100; R_0603_1608Metric_Pad0.84x1.00mm_HandSolder; part_num RESS-006
R19: 10K; R_0603_1608Metric_Pad0.84x1.00mm_HandSolder; part_num RESS-005
R20: 0; R_0603_1608Metric_Pad0.84x1.00mm_HandSolder; part_num RESS-001
TP6: TEST; TestPoint_Pad_D1.5mm
U4: STM32F765ZGT6; LQFP-144_20x20mm_P0.5mm; part_num CHIP-001
Y1: 32.768kHz; Crystal_SMD_MicroCrystal_CC7V-T1A-2Pin_3.2x1.5mm; part_num XTAL-001
Y2: 8MHz; Crystal_SMD_5032-2Pin_5.0x3.2mm_HandSoldering; part_num XTAL-002

Connections:
/3V3: C24.1, C25.1, C26.1, C27.1, C28.1, C29.1, C30.1, C31.1, C32.2, C33.1, C34.1, C35.1, C36.1, C37.2, C38.2, R20.1, U4.6 (VBAT), U4.17 (VDD), U4.30 (VDD), U4.32 (VREF+), U4.33 (VDDA), U4.39 (VDD), U4.52 (VDD), U4.62 (VDD), U4.72 (VDD), U4.84 (VDD), U4.95 (VDDUSB), U4.108 (VDD), U4.121 (VDDSDMMC), U4.131 (VDD), U4.144 (VDD); also elsewhere on the board
/AIRSPD_ADC: U4.26 (PC0); also elsewhere on the board
/CTS1: U4.103 (PA11); also elsewhere on the board
/CTS2: U4.34 (PA0); also elsewhere on the board
/CTS4: U4.76 (PB15); also elsewhere on the board
/JRST: U4.134 (PB4); also elsewhere on the board
/MEM_WC: U4.66 (PE13); also elsewhere on the board
/MISO1: U4.124 (PG9); also elsewhere on the board
/MISO2: U4.28 (PC2); also elsewhere on the board
/MISO4: U4.4 (PE5); also elsewhere on the board
/MISO5: U4.20 (PF8); also elsewhere on the board
/MISO6: U4.42 (PA6); also elsewhere on the board
/MOSI1: U4.123 (PD7); also elsewhere on the board
/MOSI2: U4.29 (PC3); also elsewhere on the board
/MOSI4: U4.5 (PE6); also elsewhere on the board
/MOSI5: U4.21 (PF9); also elsewhere on the board
/MOSI6: U4.43 (PA7); also elsewhere on the board
/NRST_PILOT: U4.25 (NRST); also elsewhere on the board
/NSS1: U4.125 (PG10); also elsewhere on the board
/NSS2: U4.73 (PB12); also elsewhere on the board
/NSS4: U4.3 (PE4); also elsewhere on the board
/NSS5: U4.18 (PF6); also elsewhere on the board
/NSS6: U4.40 (PA4); also elsewhere on the board
/PB1: U4.47 (PB1); also elsewhere on the board
/PB2: U4.48 (PB2); also elsewhere on the board
/PC4: U4.44 (PC4); also elsewhere on the board
/PC5: U4.45 (PC5); also elsewhere on the board
/RTS1: U4.104 (PA12); also elsewhere on the board
/RTS2: U4.35 (PA1); also elsewhere on the board
/RTS4: U4.75 (PB14); also elsewhere on the board
/RX1: U4.102 (PA10); also elsewhere on the board
/RX2: U4.37 (PA3); also elsewhere on the board
/RX3: U4.78 (PD9); also elsewhere on the board
/RX4: U4.114 (PD0); also elsewhere on the board
/SCK1: U4.126 (PG11); also elsewhere on the board
/SCK2: U4.74 (PB13); also elsewhere on the board
/SCK4: U4.1 (PE2); also elsewhere on the board
/SCK5: U4.19 (PF7); also elsewhere on the board
/SCK6: U4.41 (PA5); also elsewhere on the board
/SCL1: U4.136 (PB6); also elsewhere on the board
/SCL2: U4.69 (PB10); also elsewhere on the board
/SCL4: U4.54 (PF14); also elsewhere on the board
/SCLK_PILOT: U4.109 (PA14); also elsewhere on the board
/SDA1: U4.137 (PB7); also elsewhere on the board
/SDA2: U4.70 (PB11); also elsewhere on the board
/SDA4: U4.55 (PF15); also elsewhere on the board
/SD_CK: U4.113 (PC12); also elsewhere on the board
/SD_CMD: U4.116 (PD2); also elsewhere on the board
/SD_D0: U4.98 (PC8); also elsewhere on the board
/SD_D1: U4.99 (PC9); also elsewhere on the board
/SD_D2: U4.111 (PC10); also elsewhere on the board
/SD_D3: U4.112 (PC11); also elsewhere on the board
/SWIO_PILOT: U4.105 (PA13); also elsewhere on the board
/TDI: U4.110 (PA15); also elsewhere on the board
/TDO: U4.133 (PB3); also elsewhere on the board
/TX1: U4.101 (PA9); also elsewhere on the board
/TX2: U4.36 (PA2); also elsewhere on the board
/TX3: U4.77 (PD8); also elsewhere on the board
/TX4: U4.115 (PD1); also elsewhere on the board
/ULTRA_SONIC_1: U4.139 (PB8); also elsewhere on the board
/ULTRA_SONIC_2: U4.140 (PB9); also elsewhere on the board
/V_ISENSE_ADC: U4.46 (PB0); also elsewhere on the board
GND: C22.2, C23.2, C24.2, C25.2, C26.2, C27.2, C28.2, C29.2, C30.2, C31.2, C32.1, C33.2, C34.2, C35.2, C36.2, C37.1, C38.1, C39.2, C40.2, C41.1, C42.1, R16.2, R17.2, R18.2, R19.1, U4.16 (VSS), U4.31 (VSSA), U4.38 (VSS), U4.51 (VSS), U4.61 (VSS), U4.83 (VSS), U4.94 (VSS), U4.107 (VSS), U4.120 (VSS), U4.130 (VSS); also elsewhere on the board
unnamed: C22.1, U4.9 (PC15), Y1.1
unnamed: C23.1, U4.8 (PC14), Y1.2
unnamed: C39.1, U4.24 (PH1), Y2.2
unnamed: C40.1, U4.23 (PH0), Y2.1
unnamed: C41.2, U4.71 (VCAP_1)
unnamed: C42.2, U4.106 (VCAP_2)
unnamed: D5.1 (K), R16.1
unnamed: D5.2 (A), U4.58 (PE7)
unnamed: D6.1 (K), R17.1
unnamed: D6.2 (A), U4.56 (PG0)
unnamed: D7.1 (K), R18.1
unnamed: D7.2 (A), U4.57 (PG1)
unnamed: R19.2, TP6.1, U4.138 (BOOT0)
unnamed: R20.2, U4.143 (PDR_ON)

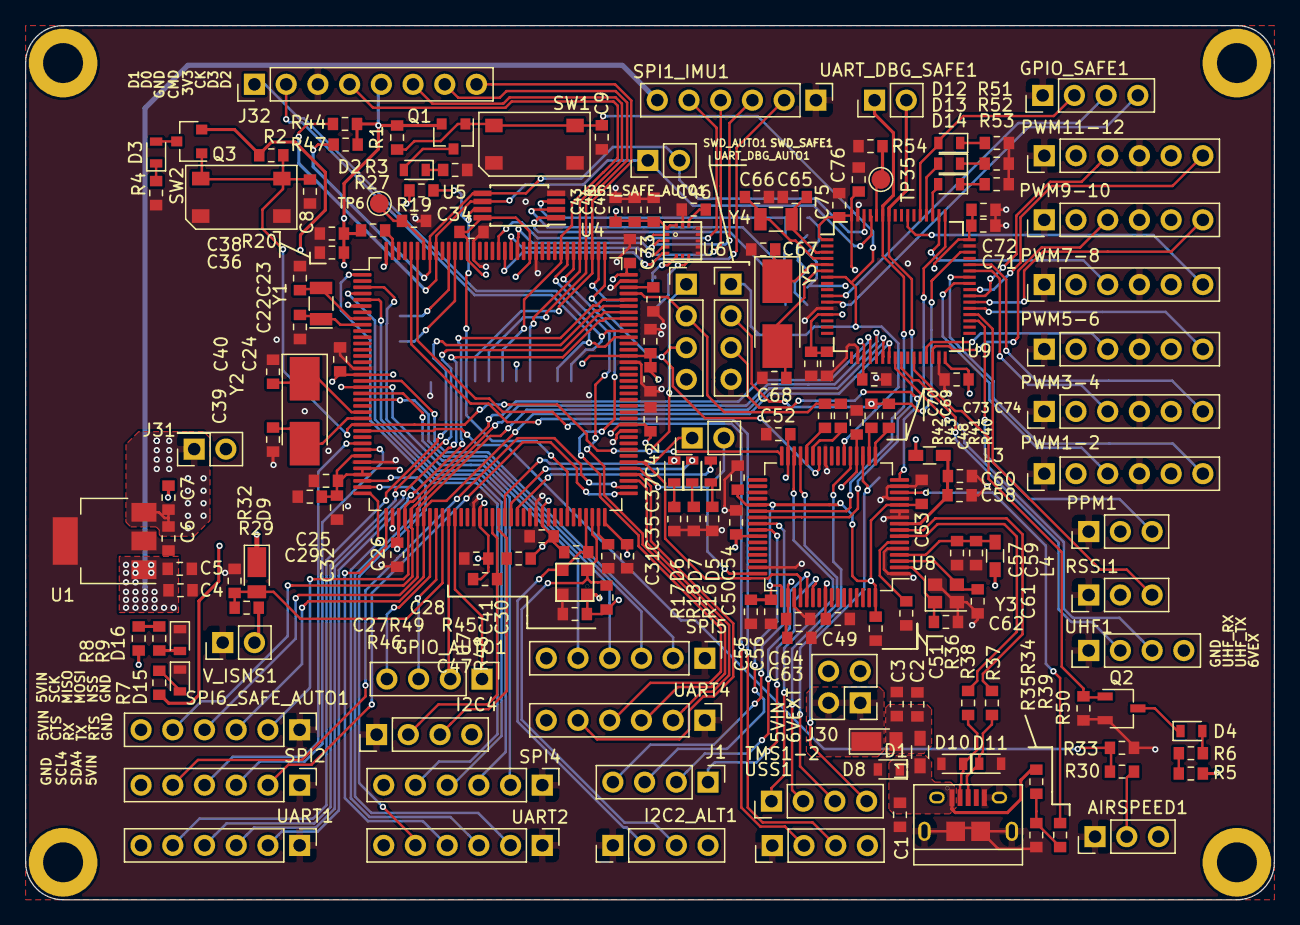
[picture p36: board ZP-Breakout.kicad_pcb from above]

Board: 4 copper layers, 100.0 x 70.0 mm, 193 parts (0 on the bottom side), 160 nets.

Other parts of the board:
TMS1-2: GH-4; PinHeader_1x04_P2.54mm_Vertical

Their connections:
/TDO1_TST: TMS1-2.4; also elsewhere on the board
/TDO2_TST: TMS1-2.2; also elsewhere on the board
/TMS1_TST: TMS1-2.3; also elsewhere on the board
/TMS2_TST: TMS1-2.1; also elsewhere on the board
