UWARG/ZP-breakout/(commit log)

2021-01-24 Schematic done, tentative placement
    [ADC_voltage_dividers.sch, HEADERS.sch, MEMORY.sch, POWER.sch, PWM_1-12.sch, SENSORS.sch, STM32F0 RELAY.sch, STM32F7 IO.sch]
2021-02-01 Finished routing. TODO: Silk.
    [HEADERS.sch, POWER.sch, ZP-Breakout.kicad_pcb]
2021-02-02 Added additional headers to some interfaces, GPIOs, and FTDI pins. Added silks
    [ADC_voltage_dividers.sch, HEADERS.sch, MEMORY.sch, POWER.sch, PWM_1-12.sch, SENSORS.sch, STM32F0 RELAY.sch, STM32F7 IO.sch]
2021-02-02 associated components to their JLC part numbers
    [ADC_voltage_dividers.sch, HEADERS.sch, MEMORY.sch, POWER.sch, PWM_1-12.sch, SENSORS.sch, STM32F0 RELAY.sch, STM32F7 IO.sch]
